kelvinchow23/photo-reactor/README.md

# Photoreactor Rev B

An update to the [AC-SDL4 photo-reactor](https://github.com/AC-SDL4/photo-reactor)
using custom PCBs for a four-reactor controller and interchangeable LED/fan boards.

The **photoreactor project is Rev B**. Both PCB parts remain **Rev A**:
SDL4-0001 photoreactor-controller and SDL4-0002 photoreactor-led.

- [PCB designs, BOMs, Gerbers and STEP models](electrical/README.md)
- [MicroPython test programs](firmware/README.md)
- [Wiring diagram](electrical/docs/wiring/photoreactor-wiring.pdf)
- [DigiKey import list](electrical/outputs/procurement/2026-10-15/DigiKey-bulk-import.txt)
- [Housing development](mechanical/housing/README.md)

Prototype bring-up is in progress; see [bench results](docs/bench-results.md).
Housing CAD will be added later.
