kelvinchow23/photo-reactor/mechanical/README.md

# Mechanical files

- [New housing development](housing/README.md)
- [PCB mechanical assemblies, STEP and previews](../electrical/outputs/mechanical/Rev-A/SDL4_REV_A_mechanical-models.zip)

The housing belongs to the Photoreactor Rev B project; the PCB model package
reflects physical Rev A boards. Housing CAD will be added when ready.
