kelvinchow23/photo-reactor/electrical/outputs/controller/SDL4-0001_photoreactor-controller_Rev-A_2026-10-08/reports/back-silkscreen.png

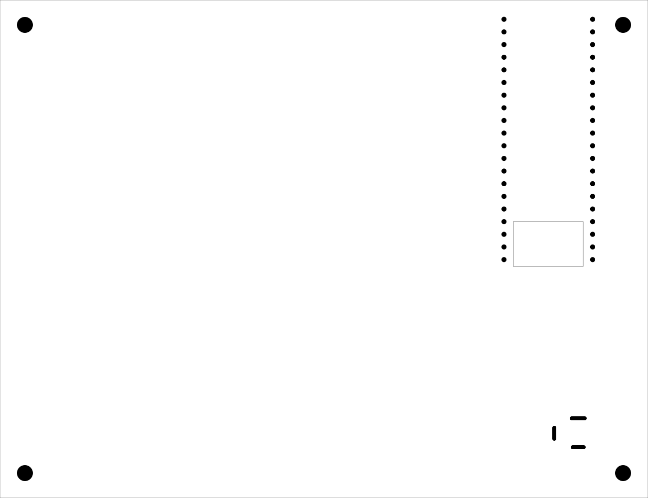
electrical/outputs/controller/SDL4-0001_photoreactor-controller_Rev-A_2026-10-08/reports/back-silkscreen.png
