kelvinchow23/photo-reactor/mechanical/housing/outputs/Rev-B/images/PR-RevB_Base_iso-back.png

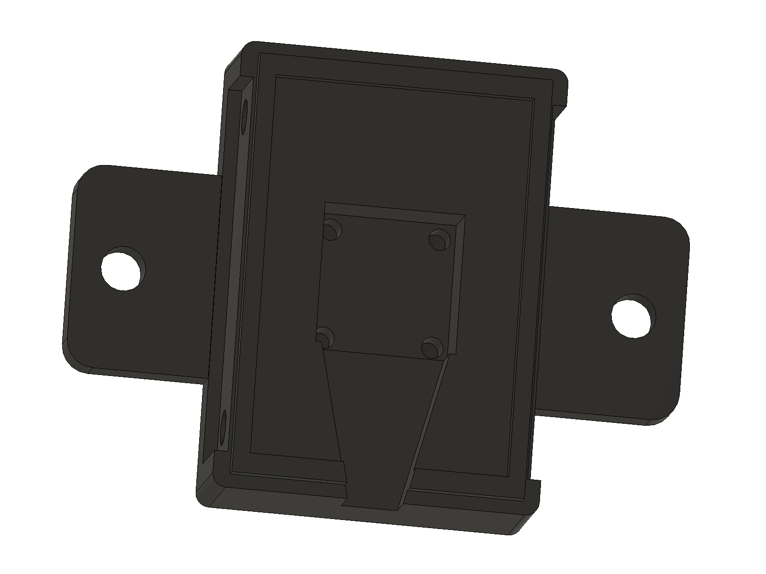
mechanical/housing/outputs/Rev-B/images/PR-RevB_Base_iso-back.png
