kelvinchow23/photo-reactor/mechanical/housing/outputs/Rev-B/images/PR-RevB_Insert_8mL_iso-back.png

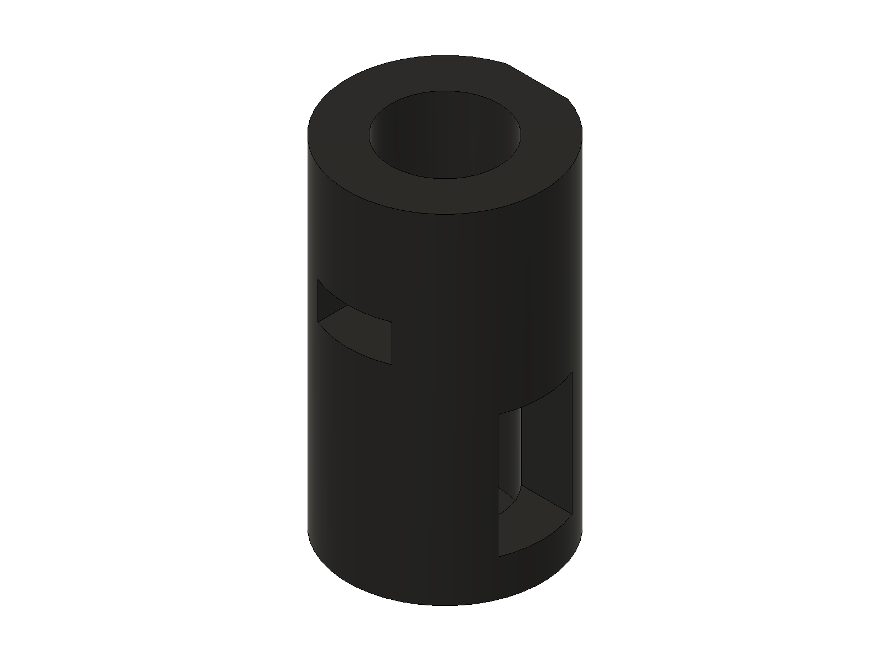
mechanical/housing/outputs/Rev-B/images/PR-RevB_Insert_8mL_iso-back.png
