kelvinchow23/photo-reactor/mechanical/housing/outputs/Rev-B/images/PR-RevB_Tower_iso-back.png

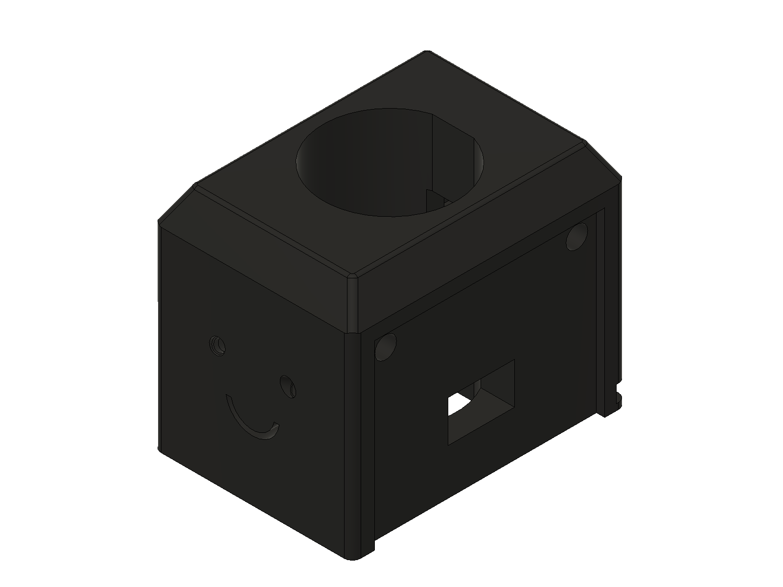
mechanical/housing/outputs/Rev-B/images/PR-RevB_Tower_iso-back.png
