kelvinchow23/photo-reactor/electrical/outputs/led_board/SDL4-0002_photoreactor-led_Rev-A_2026-10-08/SDL4-0002_photoreactor-led_Rev-A_2026-10-08_BOM.csv

Comment | Designator | Footprint | LCSC Part #
CL21A106KAYNNNE | C1 | C_0805_2012Metric | C15850
CC0805KRX7R9BB104 | C2 | C_0805_2012Metric | C49678
XL-HD6070UGC-A2-BD | D1 | LED_XINGLIGHT_XL_HD6070UGC_A2_BD | C42458855
JXT-IDC2.54-2X5P-A2 | J1 | IDC-Header_2x05_P2.54mm_Vertical_SMD | C54803513
S6B-PH-SM4-TB(LF)(SN) | J2 | JST_PH_S6B-PH-SM4-TB_1x06-1MP_P2.00mm_Horizontal | C265405
S4B-PH-SM4-TB(LF)(SN) | J3 | JST_PH_S4B-PH-SM4-TB_1x04-1MP_P2.00mm_Horizontal | C265102
0805W8F1002T5E | R1 | R_0805_2012Metric | C17414
