kelvinchow23/photo-reactor/electrical/outputs/controller/SDL4-0001_photoreactor-controller_Rev-A_2026-10-08/SDL4-0001_photoreactor-controller_Rev-A_2026-10-08_BOM.csv

Comment | Designator | Footprint | LCSC Part #
0805W8F1000T5E | R11,R15,R25,R29,R39,R43,R53,R57 | R_0805_2012Metric | C17408
0805W8F1001T5E | R14,R18,R28,R32,R42,R46,R56,R60 | R_0805_2012Metric | C17513
0805W8F1002T5E | R10,R13,R17,R21,R24,R27,R31,R35,R38,R41,R45,R49,R52,R55,R59,R7 | R_0805_2012Metric | C17414
0805W8F1003T5E | R1,R12,R16,R26,R3,R30,R40,R44,R54,R58 | R_0805_2012Metric | C149504
0805W8F3301T5E | R20,R23,R34,R37,R48,R51,R6,R9 | R_0805_2012Metric | C26010
0805W8F4701T5E | R2 | R_0805_2012Metric | C17673
1812L200/16DR | F1 | R_1812_4532Metric | C439873
2N7002 | Q_FAN1,Q_FAN2,Q_FAN3,Q_FAN4,Q_FAN5,Q_FAN6,Q_FAN7,Q_FAN8 | SOT-23 | C8545
AL8860WT-7 | U_LED1,U_LED2,U_LED3,U_LED4,U_LED5,U_LED6,U_LED7,U_LED8 | SOT-23-5 | C125330
B5819W SL | D_LED1,D_LED2,D_LED3,D_LED4,D_LED5,D_LED6,D_LED7,D_LED8 | D_SOD-123 | C8598
CC0805KRX7R9BB104 | C10,C13,C16,C2,C21,C24,C29,C3,C32,C37,C40,C9 | C_0805_2012Metric | C49678
CL21A106KAYNNNE | C4,C5,C8 | C_0805_2012Metric | C15850
CL21A475KAQNNNE | C12,C15,C20,C23,C28,C31,C36,C39 | C_0805_2012Metric | C1779
CL21B102KCANNNC | C17,C18,C25,C26,C33,C34,C41,C42 | C_0805_2012Metric | C15177
CL21B105KBFNNNE | C11,C14,C19,C22,C27,C30,C35,C38 | C_0805_2012Metric | C28323
CR1206FR430P05R | R19,R22,R33,R36,R47,R5,R50,R8 | R_1206_3216Metric | C175800
DMP3099L-7 | Q_REV | SOT-23 | C155244
TCC1210X7R226K250MT | C6,C7 | C_1210_3225Metric | C49118556
JXT-IDC2.54-2X5P-A2 | J_R1,J_R2,J_R3,J_R4 | JXT_IDC2.54_2X5P_A2 | C54803513
KT-0805G | D3 | LED_0805_2012Metric | C2297
MMSZ5240B | D_GZ | D_SOD-123 | C21564
PTS645SK43SMTR92LFS | SW_RST | SW_SPST_PTS645Sx43SMTR92 | C221871
RC0805FR-0718K2L | R4 | R_0805_2012Metric | C483023
SMAJ16A | D_TVS | D_SMA | C74561
SRN6045TA-680M | L2,L3,L4,L5,L6,L7,L8,L9 | L_Bourns_SRN6045TA | C1330786
SRN6045TA-6R8M | L1 | L_Bourns_SRN6045TA | C2041457
SS14 | D_VSYS | D_SMA | C2480
TPS563200DDCR | U_BUCK | SOT-23-6 | C97253
TSM-103-01-L-SV-TR | JP_FANV | Samtec_TSM-103_SV | C7074494
UWT1E101MCL1GS | C1 | CP_Elec_6.3x7.7_ControllerSilk | C87067
