kelvinchow23/photo-reactor/electrical/outputs/controller/SDL4-0001_photoreactor-controller_Rev-A_2026-10-08/step/SDL4-0001_photoreactor-controller_Rev-A_2026-10-08_mechanical-assembly.step

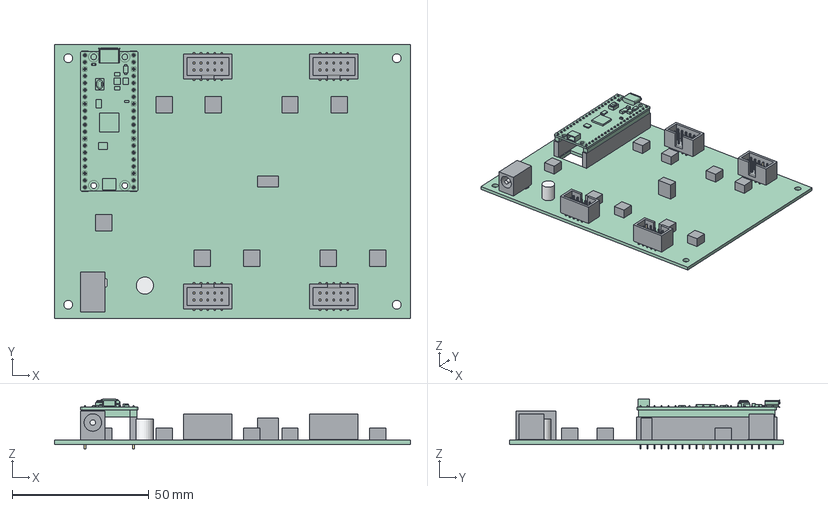
[picture p9: CAD file, 2026-11-10]
electrical/outputs/controller/SDL4-0001_photoreactor-controller_Rev-A_2026-10-08/step/SDL4-0001_photoreactor-controller_Rev-A_2026-10-08_mechanical-assembly.step
130.0 x 100.0 x 18.1 mm
PCB_nominal_finished_thickness
J_R1_housing
J_R1_contacts
J_R2_housing
J_R2_contacts
J_R3_housing
J_R3_contacts
J_R4_housing
J_R4_contacts
J_PWR_housing_envelope
J_PWR_centre_pin
J_PICO_socket_body_envelopes
J_PICO_socket_tails
J_PICO_Pico_H_KiCad_model
C1_7p7mm_height_envelope
JP_FANV_header_and_5V_shunt_envelope
L1_envelope
L2_envelope
L3_envelope
L4_envelope
L5_envelope
L6_envelope
L7_envelope
L8_envelope
L9_envelope
