kelvinchow23/photo-reactor/electrical/outputs/led_board/SDL4-0002_photoreactor-led_Rev-A_2026-10-08/step/SDL4-0002_photoreactor-led_Rev-A_2026-10-08_mechanical-assembly.step

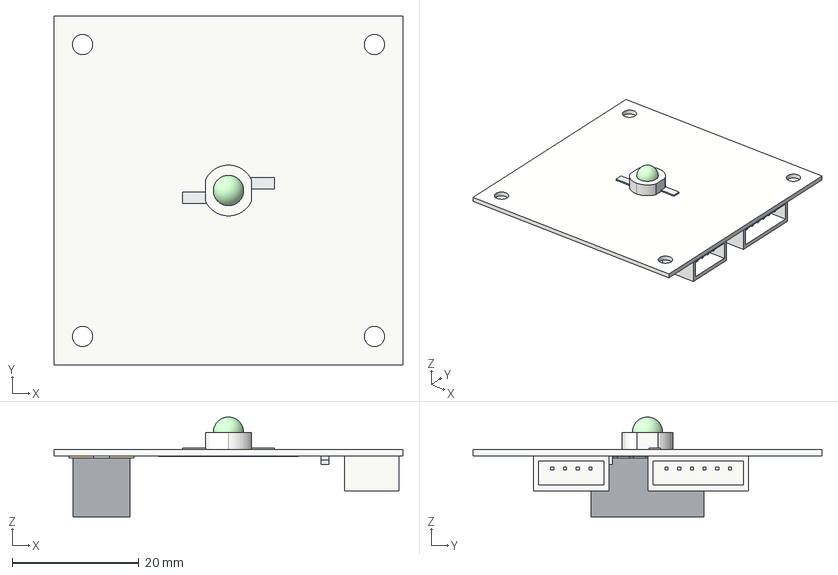
[picture p10: CAD file, 2026-11-10]
electrical/outputs/led_board/SDL4-0002_photoreactor-led_Rev-A_2026-10-08/step/SDL4-0002_photoreactor-led_Rev-A_2026-10-08_mechanical-assembly.step
55.0 x 55.0 x 15.8 mm
PCB_nominal_finished_thickness
D1_body_envelope
D1_optical_dome_approx
D1_terminals
J1_housing
J1_contacts
J2_housing_envelope
J2_contacts
J3_housing_envelope
J3_contacts
C1_envelope
C2_envelope
R1_envelope
REAR_22x22_HEATSINK_CONTACT_AREA
