kelvinchow23/photo-reactor/electrical/outputs/led_board/SDL4-0002_photoreactor-led_Rev-A_2026-10-08/step/SDL4-0002_photoreactor-led_Rev-A_2026-10-08_board-only.step

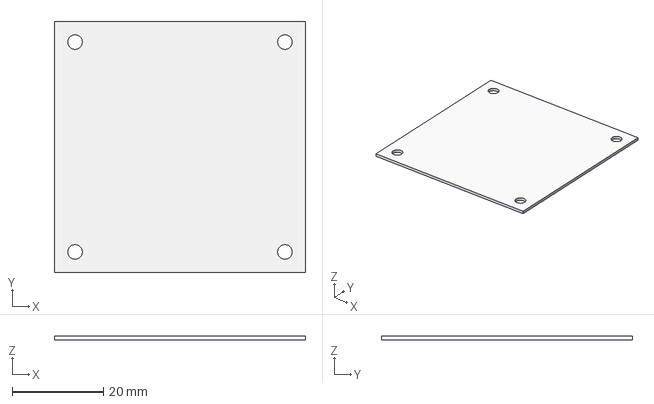
[picture p11: CAD file, 2026-11-10]
electrical/outputs/led_board/SDL4-0002_photoreactor-led_Rev-A_2026-10-08/step/SDL4-0002_photoreactor-led_Rev-A_2026-10-08_board-only.step
55.0 x 55.0 x 0.84 mm
