kelvinchow23/photo-reactor/mechanical/housing/outputs/Rev-B/step/PR-RevB_Insert_8mL.step

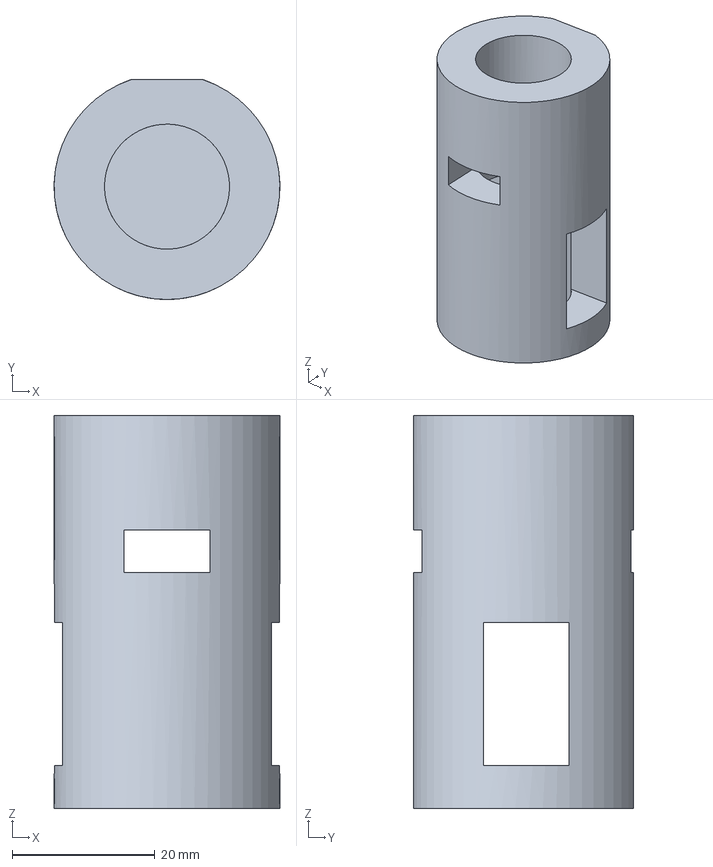
[picture p12: CAD file, 2026-11-10]
mechanical/housing/outputs/Rev-B/step/PR-RevB_Insert_8mL.step
31.6 x 30.8 x 55.0 mm
