kelvinchow23/photo-reactor/electrical/outputs/controller/SDL4-0001_photoreactor-controller_Rev-A_2026-10-08/step/SDL4-0001_photoreactor-controller_Rev-A_2026-10-08_board-only.step

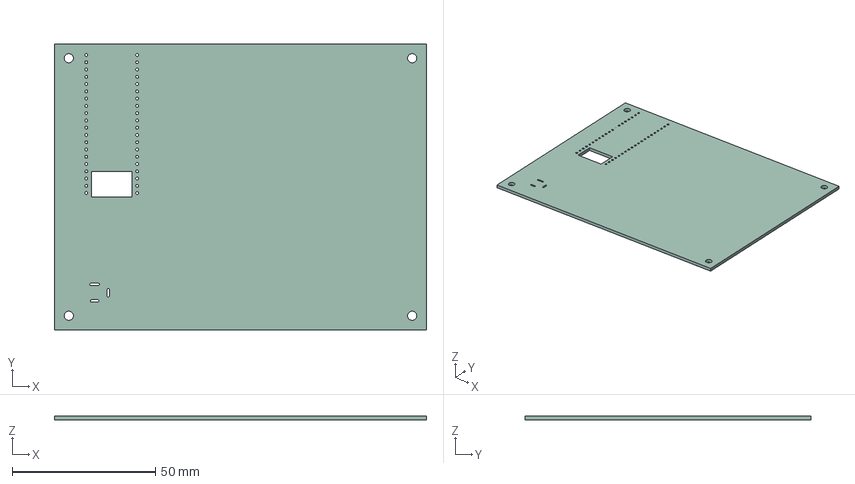
[picture p13: CAD file, 2026-11-10]
electrical/outputs/controller/SDL4-0001_photoreactor-controller_Rev-A_2026-10-08/step/SDL4-0001_photoreactor-controller_Rev-A_2026-10-08_board-only.step
130.0 x 100.0 x 1.51 mm
