kelvinchow23/photo-reactor/electrical/outputs/led_board/SDL4-0002_photoreactor-led_Rev-A_2026-10-08/step/SDL4-0002_photoreactor-led_Rev-A_2026-10-08_heatsink-clearance.step

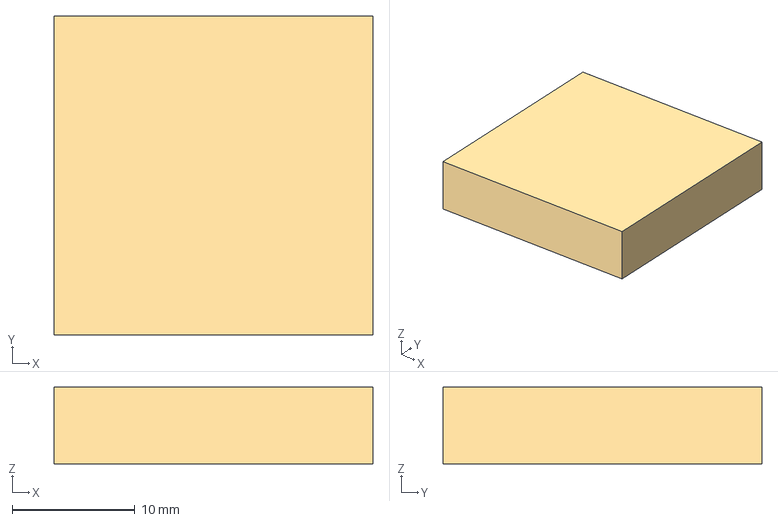
[picture p14: CAD file, 2026-11-10]
electrical/outputs/led_board/SDL4-0002_photoreactor-led_Rev-A_2026-10-08/step/SDL4-0002_photoreactor-led_Rev-A_2026-10-08_heatsink-clearance.step
26.0 x 26.0 x 6.25 mm
