kelvinchow23/photo-reactor/mechanical/housing/outputs/Rev-B/step/PR-RevB_Base.step

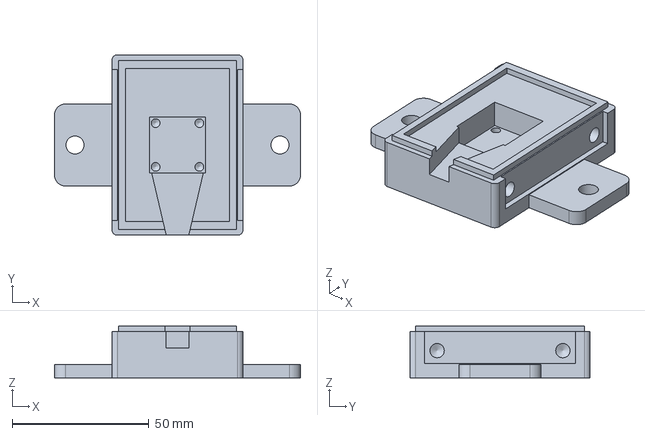
[picture p15: CAD file, 2026-11-10]
mechanical/housing/outputs/Rev-B/step/PR-RevB_Base.step
90.0 x 66.0 x 19.0 mm
