kelvinchow23/photo-reactor/mechanical/housing/outputs/Rev-B/step/PR-RevB_Tower.step

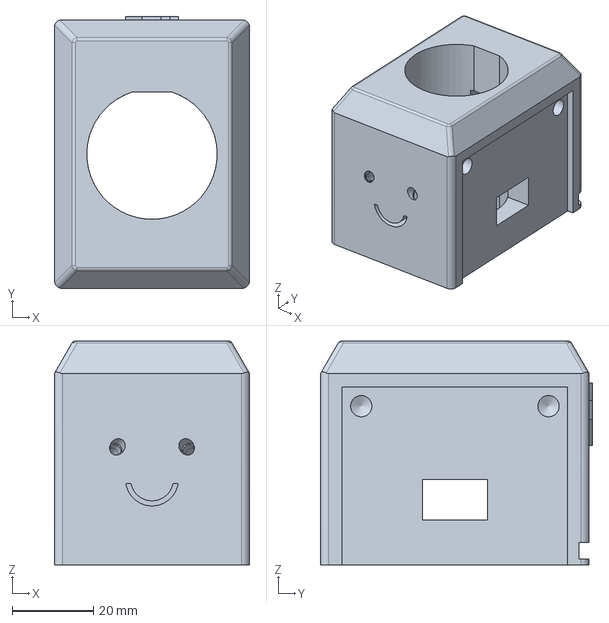
[picture p16: CAD file, 2026-11-10]
mechanical/housing/outputs/Rev-B/step/PR-RevB_Tower.step
48.0 x 66.8 x 55.0 mm
