kelvinchow23/photo-reactor/(list of files, cad)

Other CAD files:
mechanical/housing/outputs/Rev-B/stl/PR-RevB_Base.stl
mechanical/housing/outputs/Rev-B/stl/PR-RevB_Insert_8mL.stl
mechanical/housing/outputs/Rev-B/stl/PR-RevB_Tower.stl
