kelvinchow23/photo-reactor/electrical/docs/wiring/photoreactor-wiring.pdf

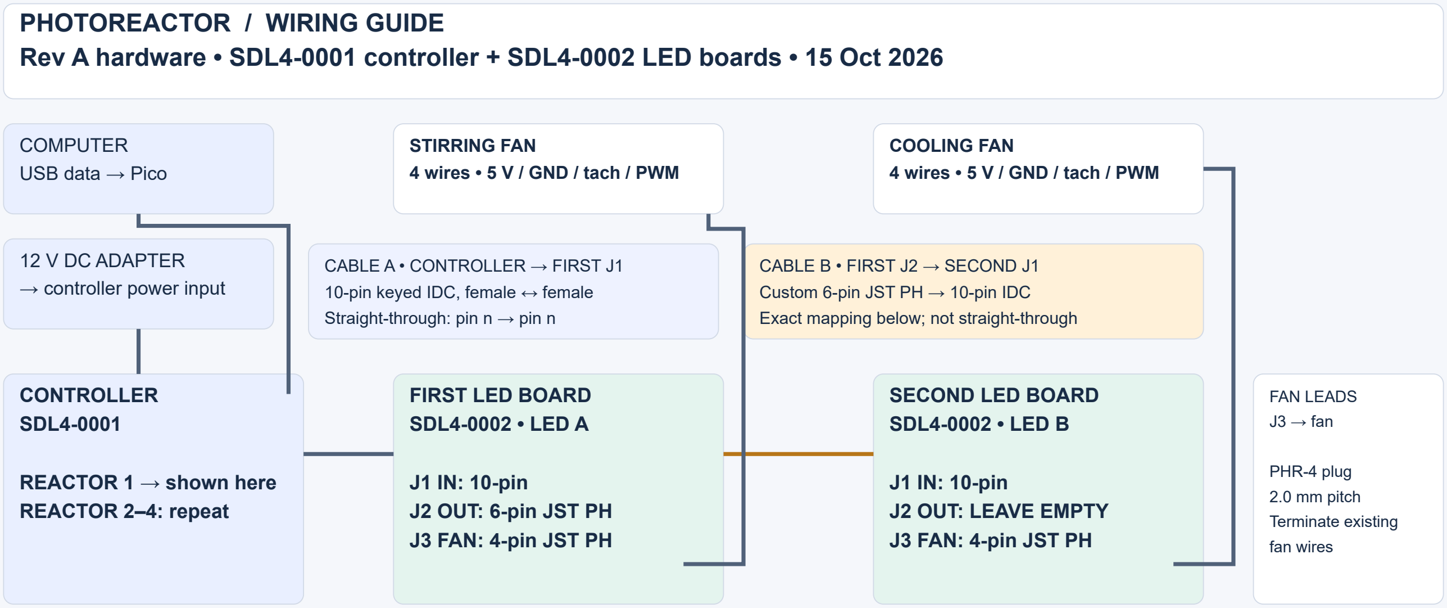
[picture p17: figure]
PHOTOREACTOR / WIRING GUIDE; COMPUTER USB data → Pico; 12 V DC ADAPTER → controller power input; CONTROLLER SDL4-0001; REACTOR 1 → shown here REACTOR 2–4: repeat; FIRST LED BOARD SDL4-0002 • LED A; J1 IN: 10-pin J2 OUT: 6-pin JST PH J3 FAN: 4-pin JST PH; SECOND LED BOARD SDL4-0002 • LED B; J1 IN: 10-pin J2 OUT: LEAVE EMPTY J3 FAN: 4-pin JST PH; CABLE A • CONTROLLER → FIRST J1 10-pin keyed IDC, female ↔ female Straight-through: pin n → pin n; CABLE B • FIRST J2 → SECOND J1 Custom 6-pin JST PH → 10-pin IDC Exact mapping below; not straight-through; STIRRING FAN 4 wires • 5 V / GND / tach / PWM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

## Rev A hardware • SDL4-0001 controller + SDL4-0002 LED boards • 15 Oct 2026

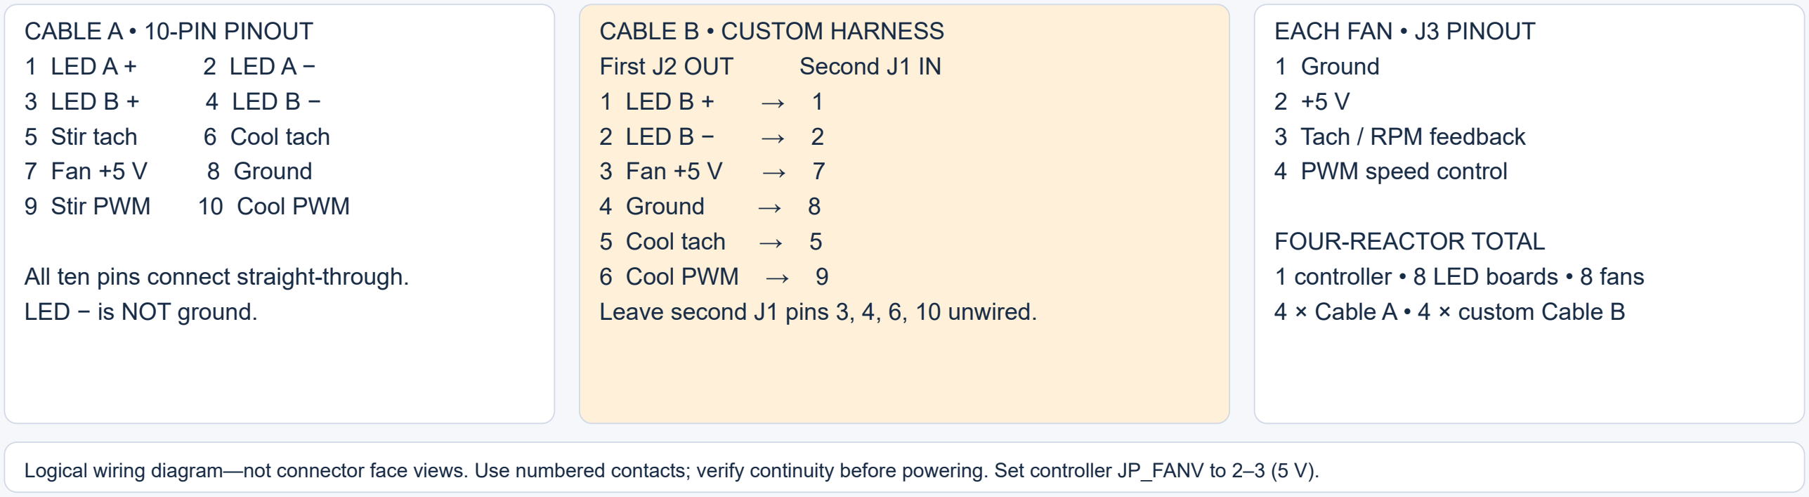
[picture p18: figure]
CABLE A • 10-PIN PINOUT; 1 LED A +; 2 LED A −; 3 LED B +; 4 LED B −; 5 Stir tach; 6 Cool tach; 7 Fan +5 V; 8 Ground; 9 Stir PWM; 10 Cool PWM; All ten pins connect straight-through. LED − is NOT ground.; CABLE B • CUSTOM HARNESS; First J2 OUT; Second J1 IN; 1 LED B +; 2 LED B −; 3 Fan +5 V; 4 Ground; 5 Cool tach; 6 Cool PWM → 9; EACH FAN • J3 PINOUT 1 Ground 2 +5 V 3 Tach / RPM feedback 4 PWM speed control; FOUR-REACTOR TOTAL 1 controller • 8 LED boards • 8 fans 4 × Cable A • 4 × custom Cable B

Leave second J1 pins 3, 4, 6, 10 unwired.

Logical wiring diagram—not connector face views. Use numbered contacts; verify continuity before powering. Set controller JP_FANV to 2–3 (5 V).
