kelvinchow23/photo-reactor/electrical/docs/wiring/photoreactor-wiring.png

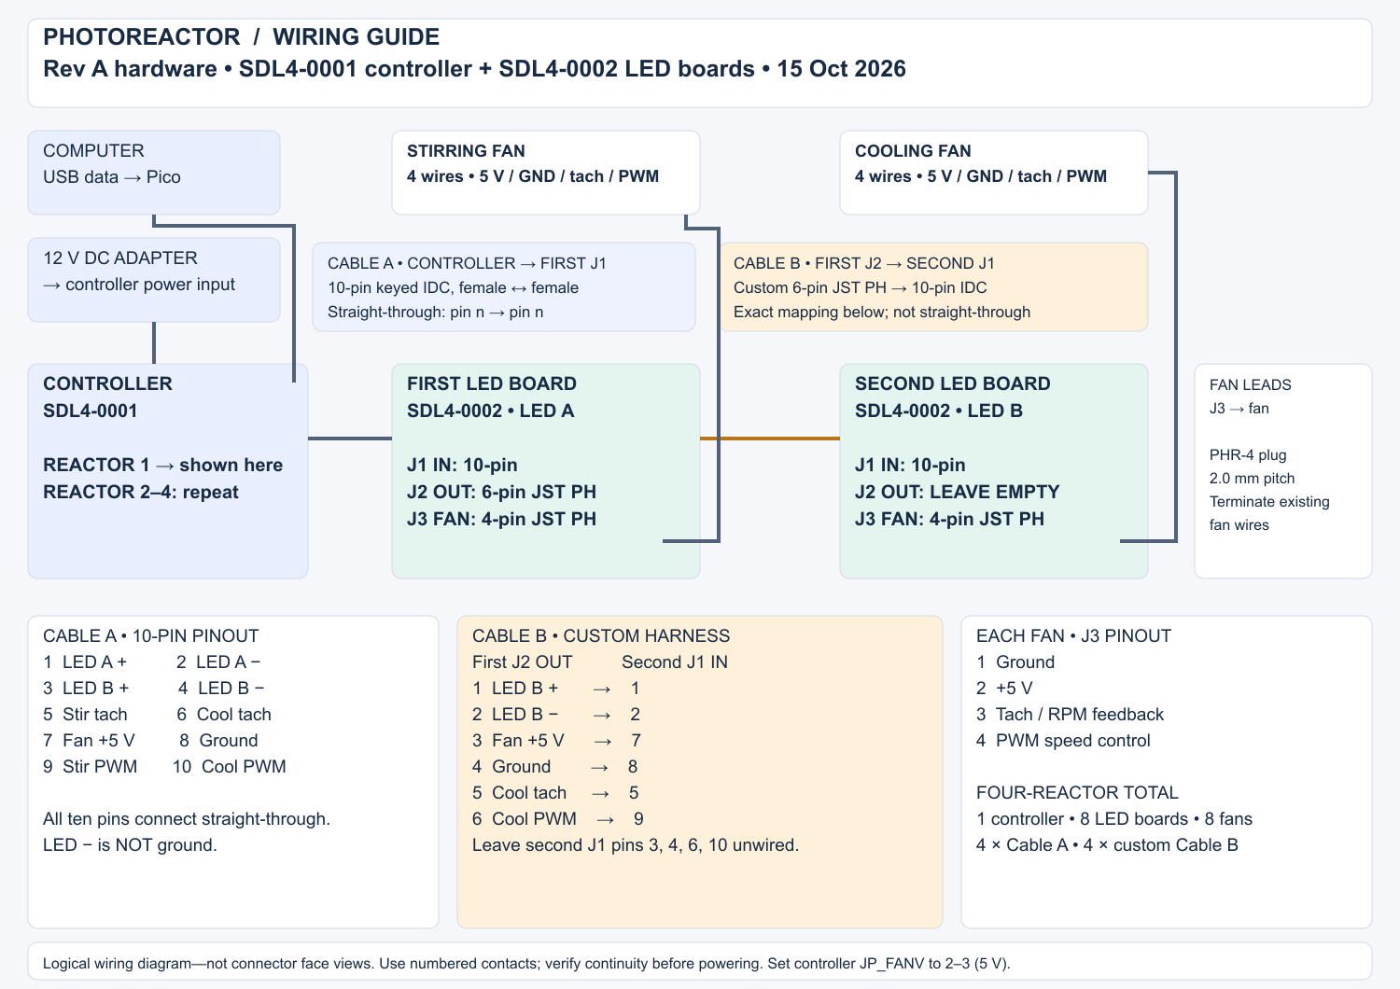
electrical/docs/wiring/photoreactor-wiring.png
