kelvinchow23/photo-reactor/electrical/outputs/led_board/SDL4-0002_photoreactor-led_Rev-A_2026-10-08/step/mechanical-assembly-top.png

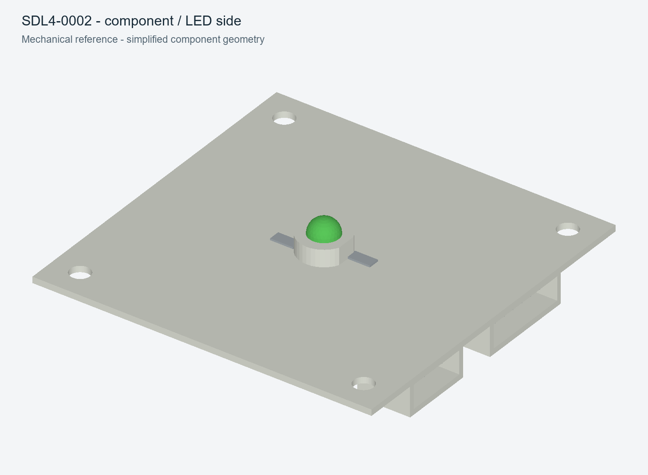
electrical/outputs/led_board/SDL4-0002_photoreactor-led_Rev-A_2026-10-08/step/mechanical-assembly-top.png
