kelvinchow23/photo-reactor/electrical/designs/led_board/photoreactor_led.kicad_pcb

## KiCad design electrical/designs/led_board/photoreactor_led.kicad_pcb (2026-11-10)

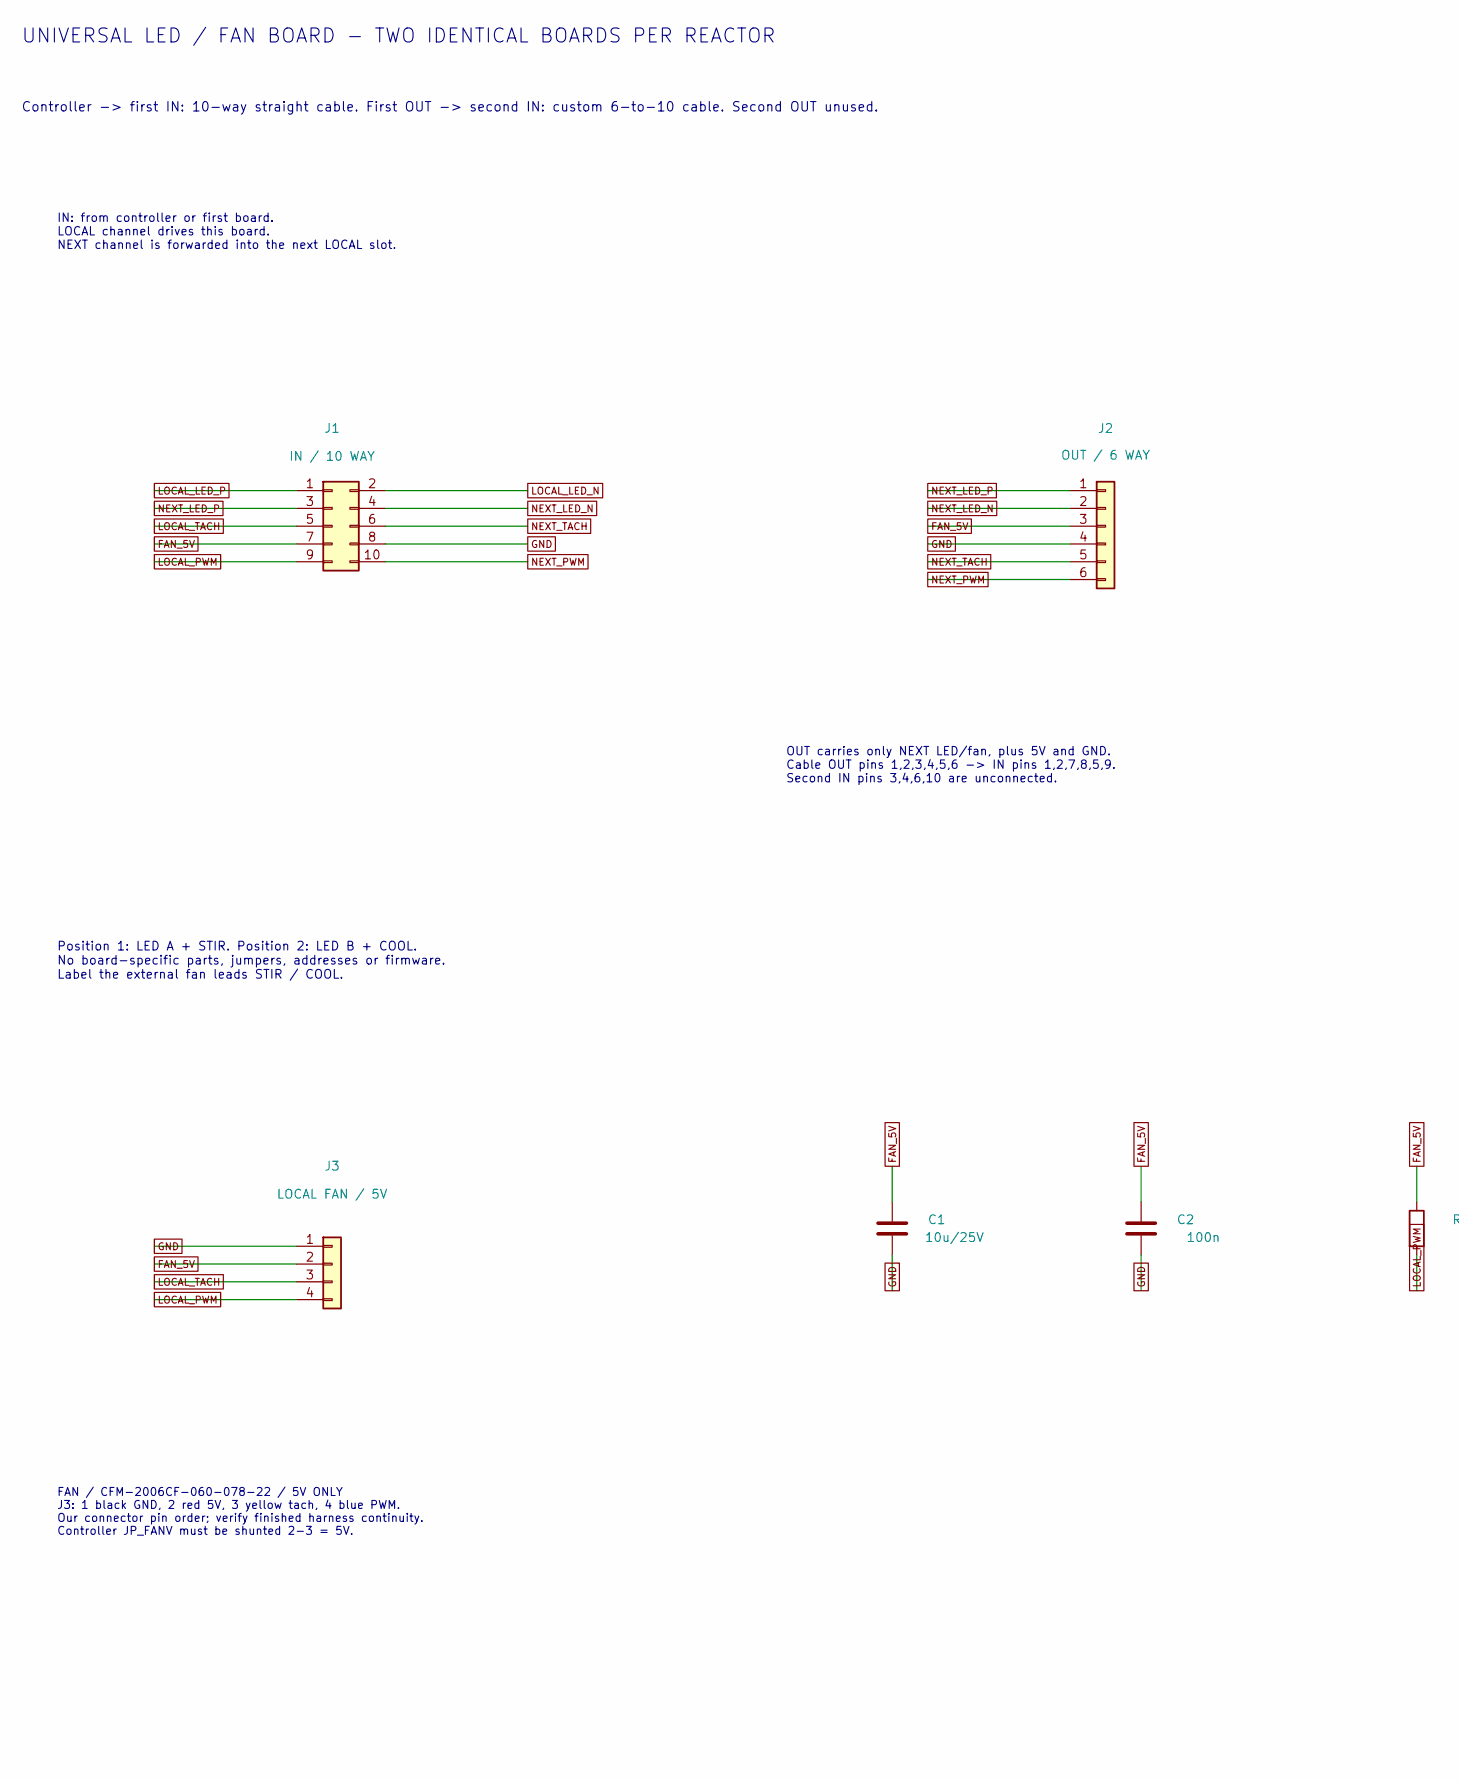
[picture p24: schematic photoreactor_led.kicad_sch, C.5 square LED and fan board, part in row 1, column 1]

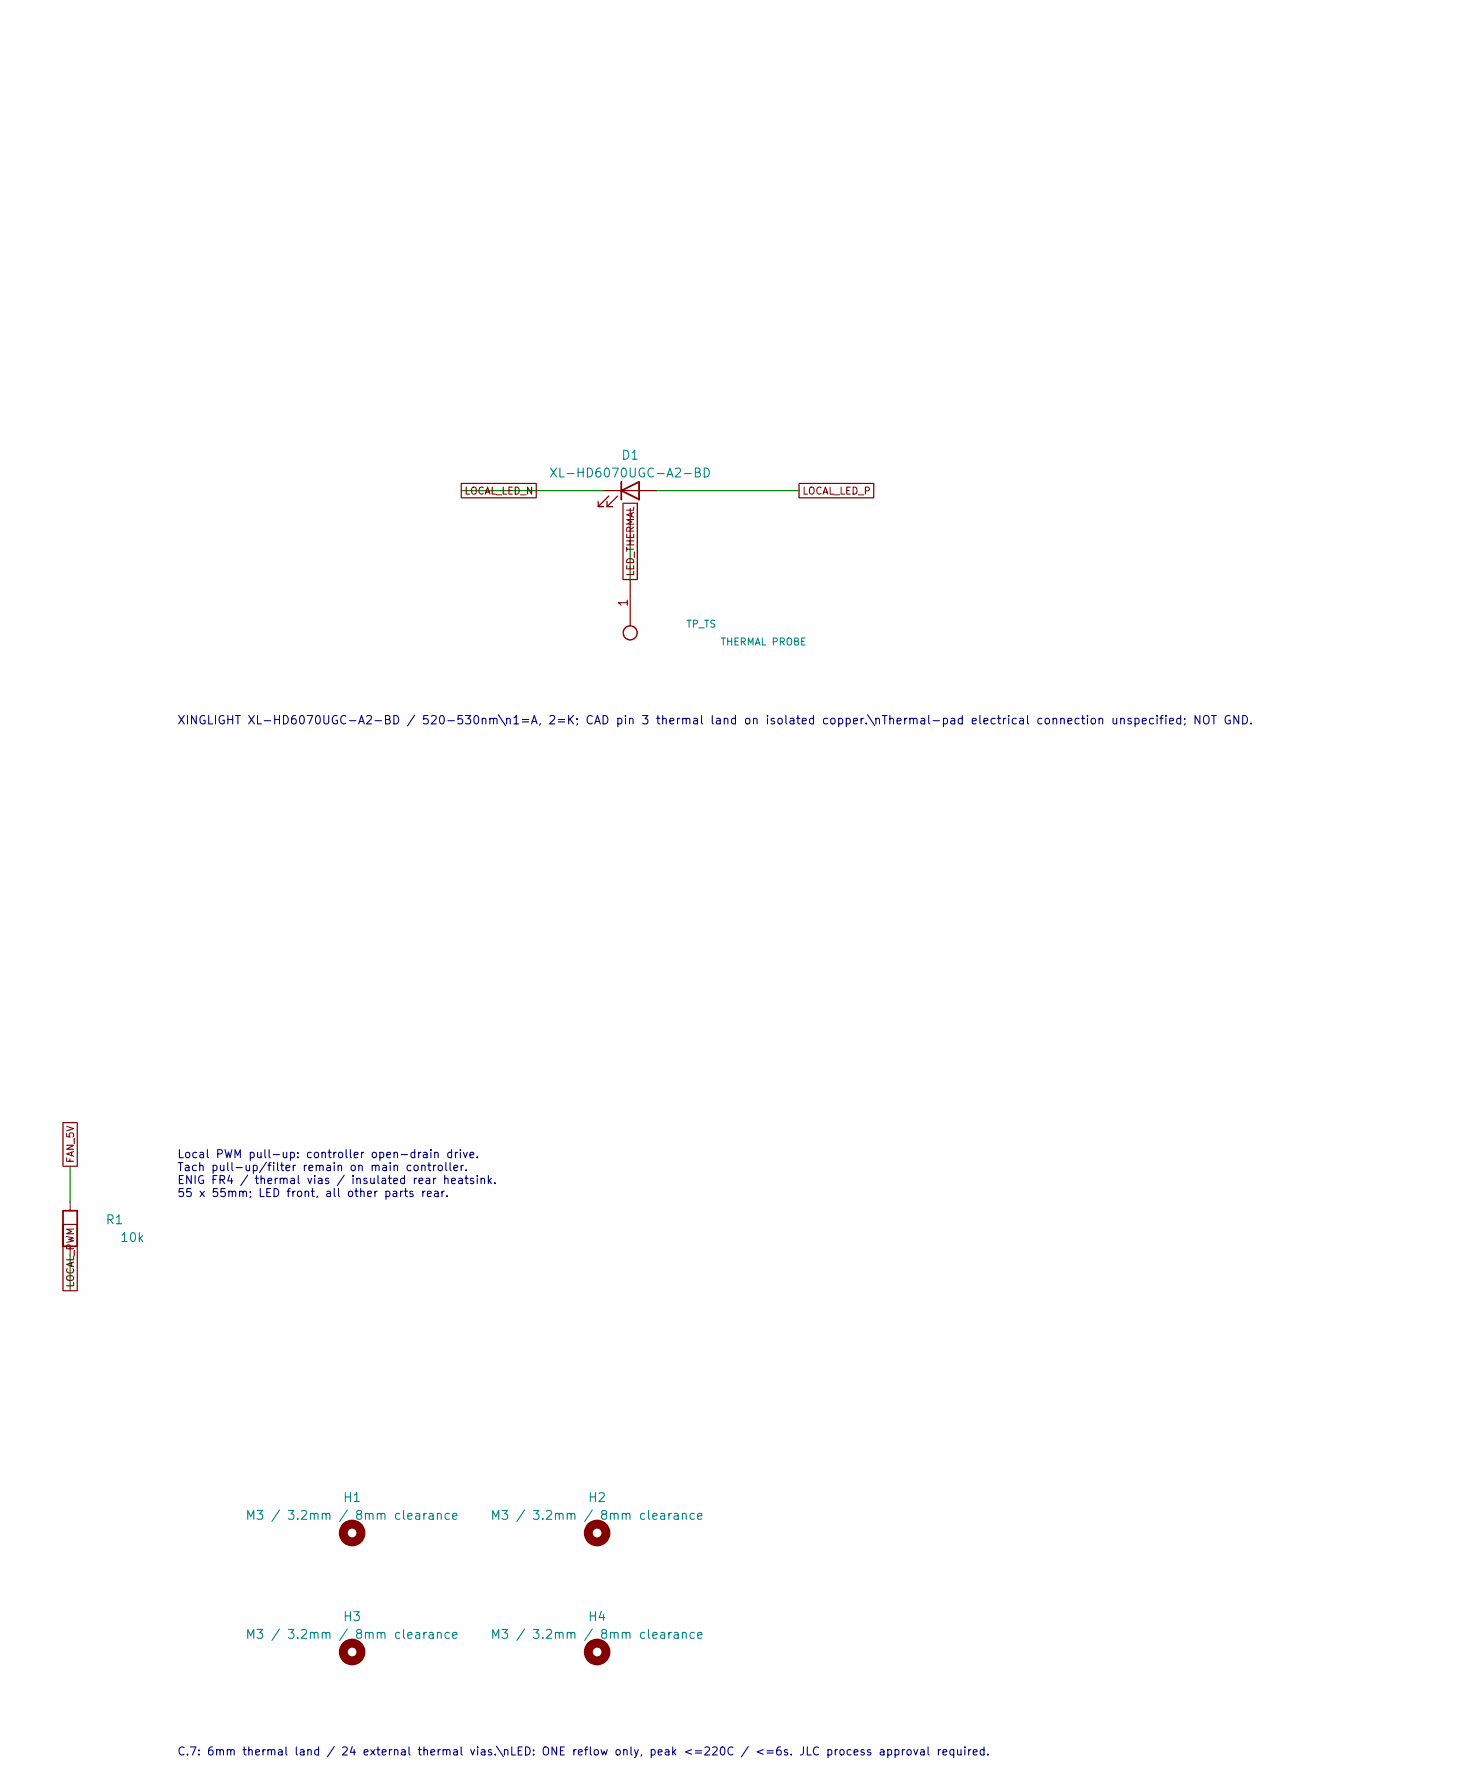
[picture p25: schematic photoreactor_led.kicad_sch, C.5 square LED and fan board, part in row 1, column 2]

Parts:
C1: 10u/25V; C_0805_2012Metric; MPN CL21A106KAYNNNE
C2: 100n; C_0805_2012Metric; MPN CC0805KRX7R9BB104
D1: XL-HD6070UGC-A2-BD; LED_XINGLIGHT_XL_HD6070UGC_A2_BD; MPN XL-HD6070UGC-A2-BD
H1, H2, H3, H4: M3 / 3.2mm / 8mm clearance; MountingHole_M3_3.2mm_8mm_Clearance
J1: IN / 10 WAY; IDC-Header_2x05_P2.54mm_Vertical_SMD; MPN JXT-IDC2.54-2X5P-A2
J2: OUT / 6 WAY; JST_PH_S6B-PH-SM4-TB_1x06-1MP_P2.00mm_Horizontal; MPN S6B-PH-SM4-TB(LF)(SN)
J3: LOCAL FAN / 5V; JST_PH_S4B-PH-SM4-TB_1x04-1MP_P2.00mm_Horizontal; MPN S4B-PH-SM4-TB(LF)(SN)
R1: 10k; R_0805_2012Metric; MPN 0805W8F1002T5E
TP_TS: THERMAL PROBE; Thermal_Probe_Window

Connections:
FAN_5V: C1.1, C2.1, J1.7, J2.3, J3.2, R1.1
GND: C1.2, C2.2, J1.8, J2.4, J3.1
LED_THERMAL: D1.3 (TH), TP_TS.1
LOCAL_LED_N: D1.2 (K), J1.2
LOCAL_LED_P: D1.1 (A), J1.1
LOCAL_PWM: J1.9, J3.4, R1.2
LOCAL_TACH: J1.5, J3.3
NEXT_LED_N: J1.4, J2.2
NEXT_LED_P: J1.3, J2.1
NEXT_PWM: J1.10, J2.6
NEXT_TACH: J1.6, J2.5

Notes on the sheet:
UNIVERSAL LED / FAN BOARD - TWO IDENTICAL BOARDS PER REACTOR
Controller -> first IN: 10-way straight cable. First OUT -> second IN: custom 6-to-10 cable. Second OUT unused.
IN: from controller or first board. LOCAL channel drives this board. NEXT channel is forwarded into the next LOCAL slot.
OUT carries only NEXT LED/fan, plus 5V and GND. Cable OUT pins 1,2,3,4,5,6 -> IN pins 1,2,7,8,5,9. Second IN pins 3,4,6,10 are unconnected.
XINGLIGHT XL-HD6070UGC-A2-BD / 520-530nm\n1=A, 2=K; CAD pin 3 thermal land on isolated copper.\nThermal-pad electrical connection unspecified; NOT GND.
Position 1: LED A + STIR. Position 2: LED B + COOL. No board-specific parts, jumpers, addresses or firmware. Label the external fan leads STIR / COOL.
FAN / CFM-2006CF-060-078-22 / 5V ONLY J3: 1 black GND, 2 red 5V, 3 yellow tach, 4 blue PWM. Our connector pin order; verify finished harness continuity. Controller JP_FANV must be shunted 2-3 = 5V.
Local PWM pull-up: controller open-drain drive. Tach pull-up/filter remain on main controller. ENIG FR4 / thermal vias / insulated rear heatsink. 55 x 55mm; LED front, all other parts rear.
C.7: 6mm thermal land / 24 external thermal vias.\nLED: ONE reflow only, peak <=220C / <=6s. JLC process approval required.

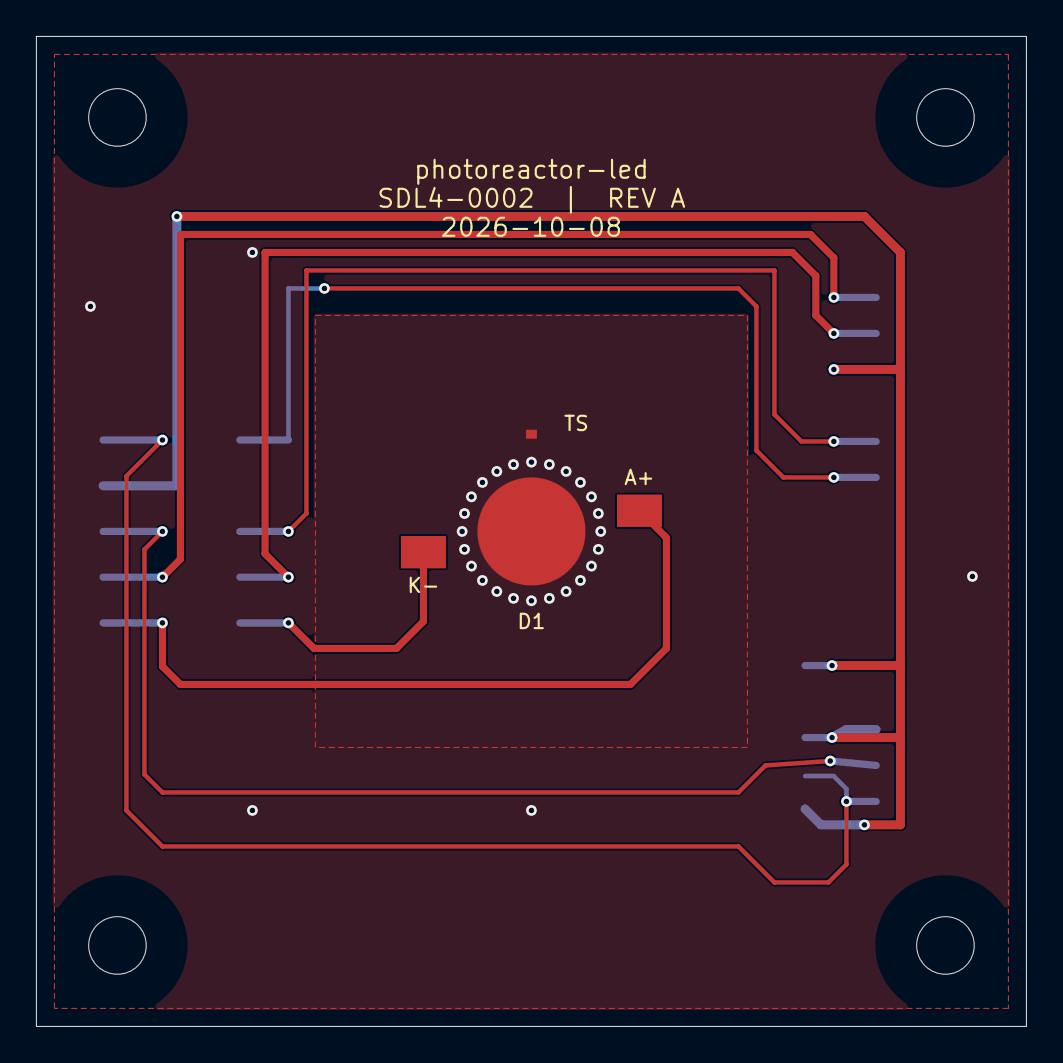
[picture p26: board photoreactor_led.kicad_pcb from above]

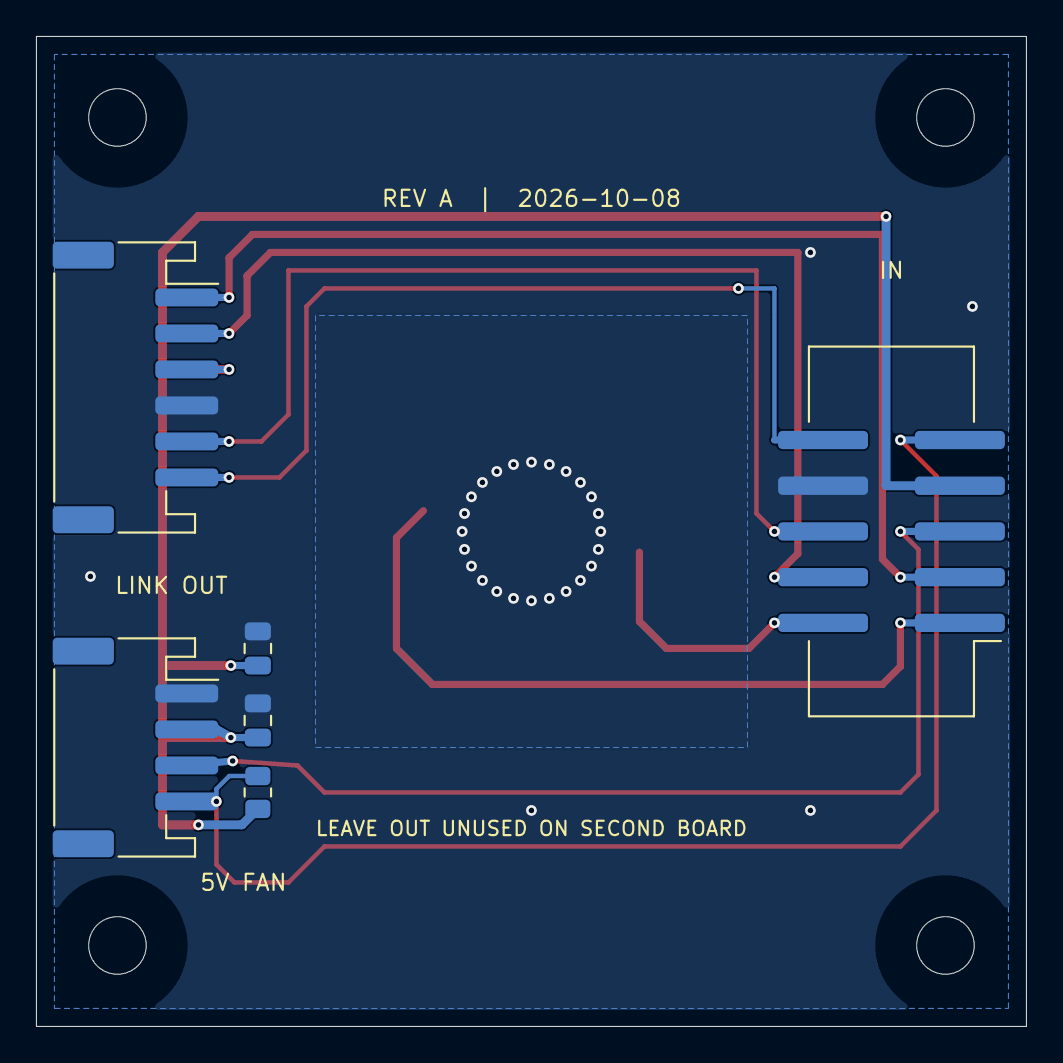
[picture p27: board photoreactor_led.kicad_pcb from below]

Board: 2 copper layers, 55.0 x 55.0 mm, 12 parts (6 on the bottom side), 11 nets.
