kelvinchow23/photo-reactor/electrical/designs/controller/photoreactor_quad.kicad_pcb

## KiCad design electrical/designs/controller/photoreactor_quad.kicad_pcb (2026-11-10)

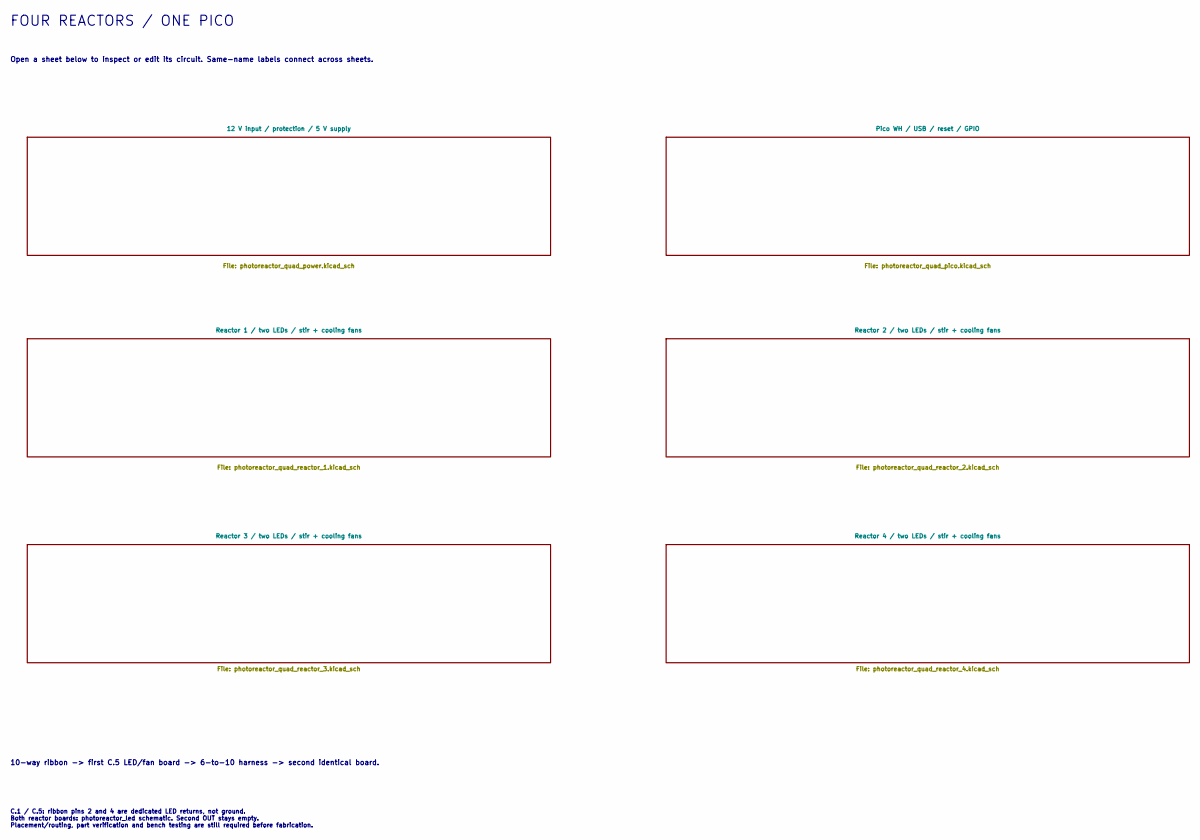
[picture p28: schematic photoreactor_quad.kicad_sch, LEDbyXample — four-reactor controller]

Notes on the sheet:
FOUR REACTORS / ONE PICO
Open a sheet below to inspect or edit its circuit. Same-name labels connect across sheets.
10-way ribbon -> first C.5 LED/fan board -> 6-to-10 harness -> second identical board.
C.1 / C.5: ribbon pins 2 and 4 are dedicated LED returns, not ground. Both reactor boards: photoreactor_led schematic. Second OUT stays empty. Placement/routing, part verification and bench testing are still required before fabrication.

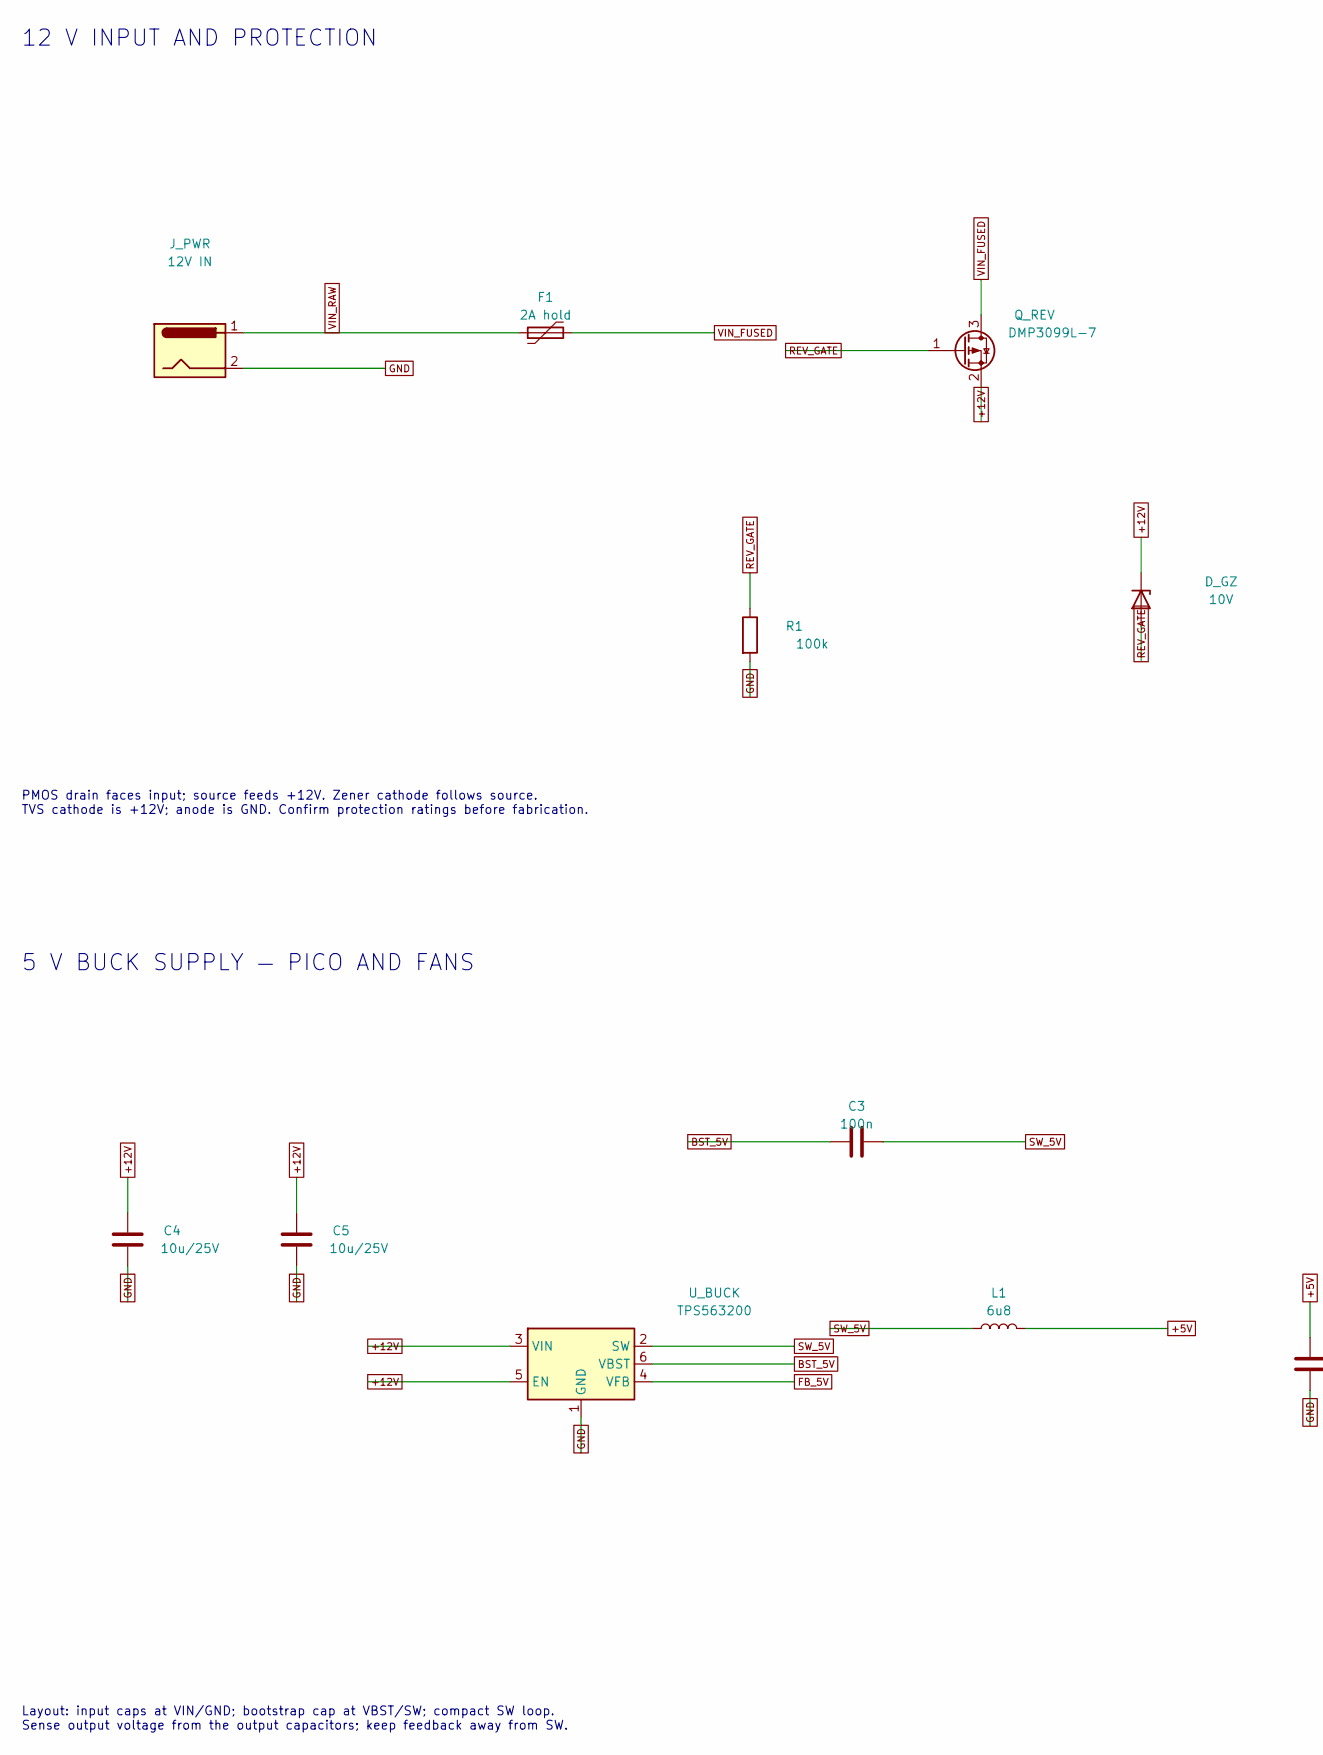
[picture p29: schematic photoreactor_quad_power.kicad_sch, Power input, protection and 5 V supply, part in row 1, column 1]

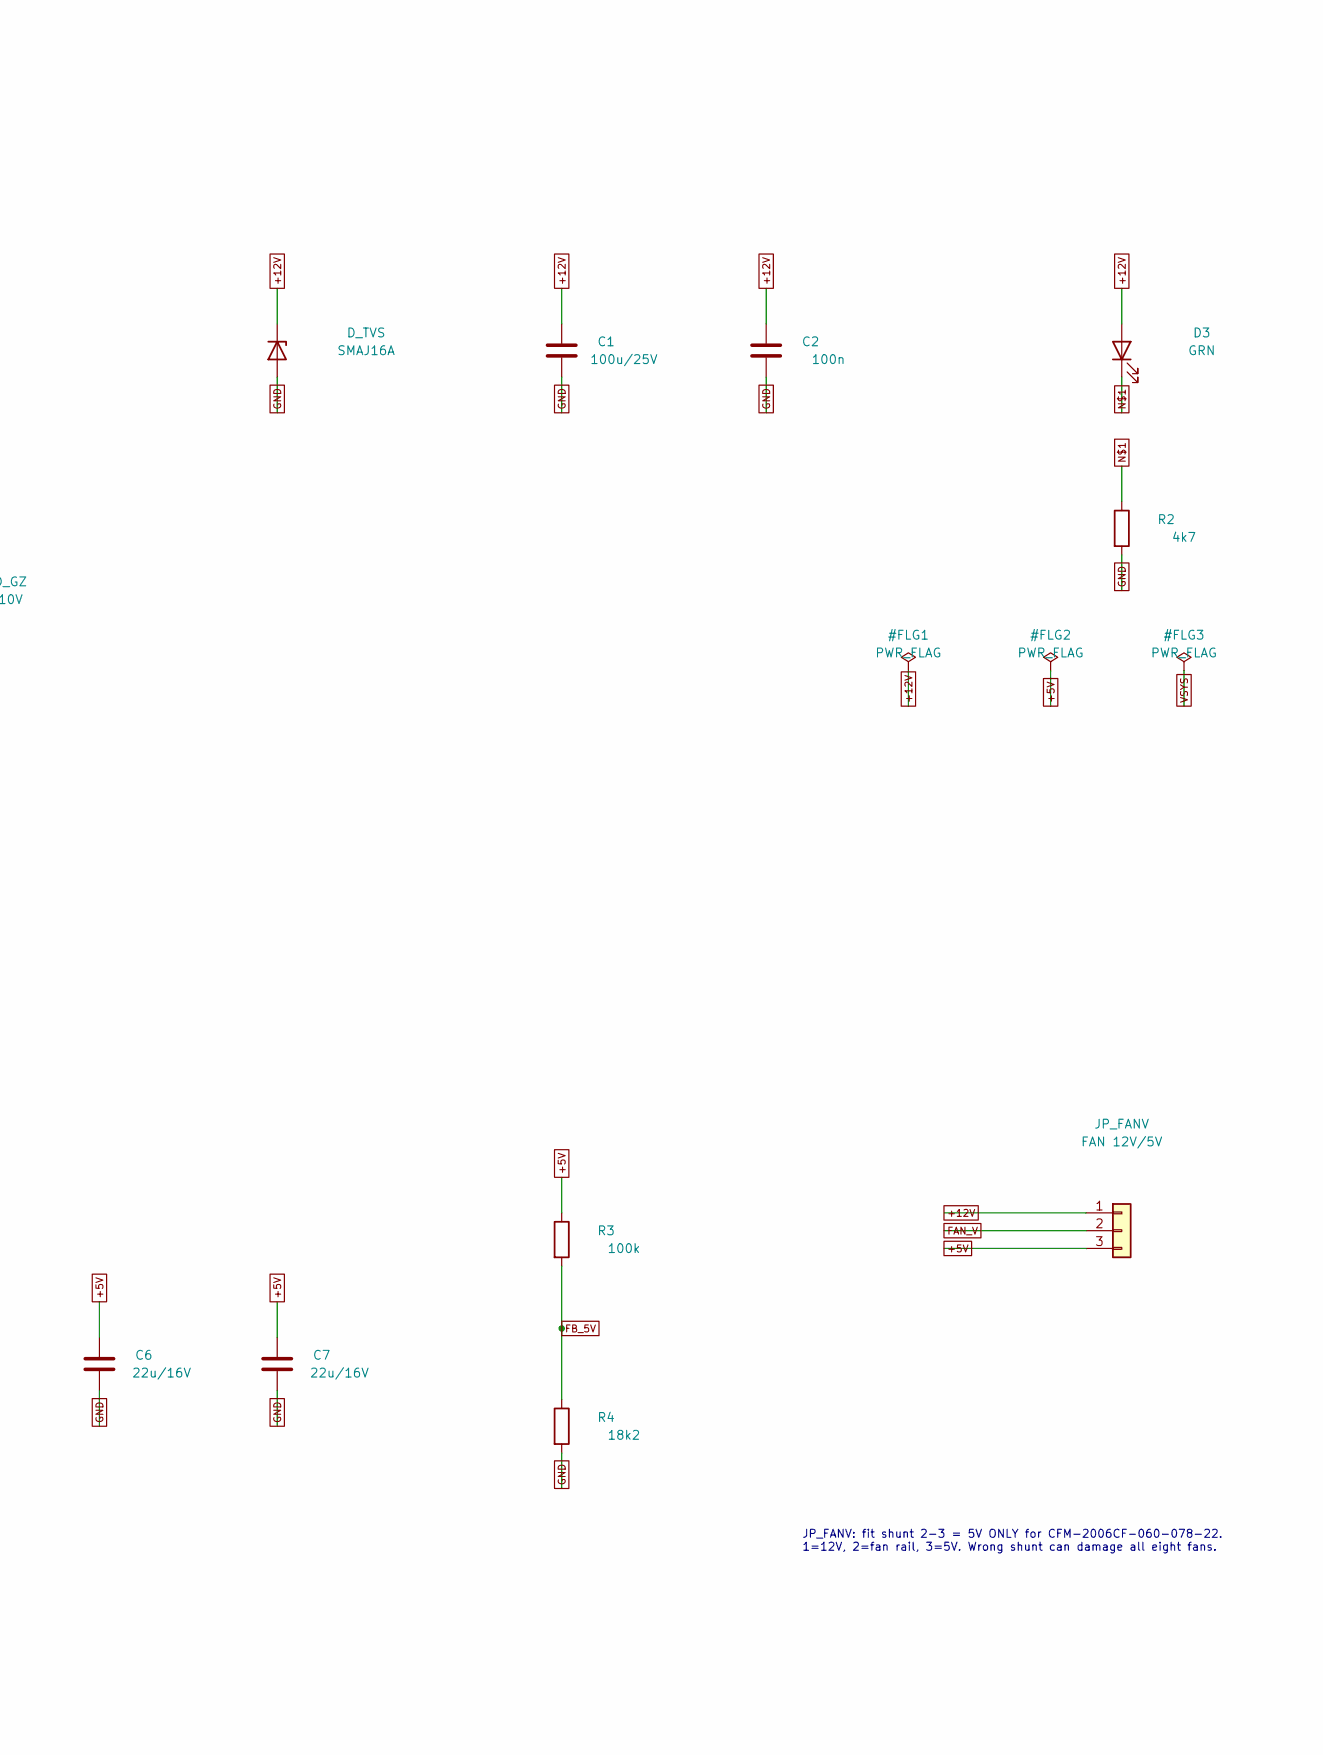
[picture p30: schematic photoreactor_quad_power.kicad_sch, Power input, protection and 5 V supply, part in row 1, column 2]

Parts:
C1: 100u/25V; CP_Elec_6.3x7.7_ControllerSilk; MPN UWT1E101MCL1GS
C2, C3: 100n; C_0805_2012Metric; MPN CC0805KRX7R9BB104; LCSC C49678
C4, C5: 10u/25V; C_0805_2012Metric; MPN CL21A106KAYNNNE; LCSC C15850
C6, C7: 22u/16V; C_1210_3225Metric; MPN TCC1210X7R226K250MT; LCSC C49118556
D3: GRN; LED_0805_2012Metric; MPN KT-0805G; LCSC C2297
D_GZ: 10V; D_SOD-123; MPN MMSZ5240B
D_TVS: SMAJ16A; D_SMA; MPN SMAJ16A
F1: 2A hold; R_1812_4532Metric; MPN 1812L200/16DR; LCSC C439873
JP_FANV: FAN 12V/5V; Samtec_TSM-103_SV; MPN TSM-103-01-L-SV-TR; LCSC C7074494
J_PWR: 12V IN; BarrelJack_Wuerth_6941xx301002; MPN 694106301002
L1: 6u8; L_Bourns_SRN6045TA; MPN SRN6045TA-6R8M
Q_REV: DMP3099L-7; SOT-23; MPN DMP3099L-7
R1, R3: 100k; R_0805_2012Metric; MPN 0805W8F1003T5E; LCSC C149504
R2: 4k7; R_0805_2012Metric; MPN 0805W8F4701T5E; LCSC C17673
R4: 18k2; R_0805_2012Metric; MPN RC0805FR-0718K2L; LCSC C483023
U_BUCK: TPS563200; SOT-23-6; MPN TPS563200DDCR

Connections:
+5V: C6.1, C7.1, JP_FANV.3, L1.2, R3.1; also elsewhere on the board
+12V: C1.1, C2.1, C4.1, C5.1, D3.2 (A), D_GZ.1 (K), D_TVS.1 (K), JP_FANV.1, Q_REV.2 (S), U_BUCK.3 (VIN), U_BUCK.5 (EN); also elsewhere on the board
BST_5V: C3.1, U_BUCK.6 (VBST)
FAN_V: JP_FANV.2; also elsewhere on the board
FB_5V: R3.2, R4.1, U_BUCK.4 (VFB)
GND: C1.2, C2.2, C4.2, C5.2, C6.2, C7.2, D_TVS.2 (A), J_PWR.2, R1.2, R2.2, R4.2, U_BUCK.1 (GND); also elsewhere on the board
unnamed: D3.1 (K), R2.1
REV_GATE: D_GZ.2 (A), Q_REV.1 (G), R1.1
SW_5V: C3.2, L1.1, U_BUCK.2 (SW)
VIN_FUSED: F1.2, Q_REV.3 (D)
VIN_RAW: F1.1, J_PWR.1

Notes on the sheet:
12 V INPUT AND PROTECTION
PMOS drain faces input; source feeds +12V. Zener cathode follows source. TVS cathode is +12V; anode is GND. Confirm protection ratings before fabrication.
5 V BUCK SUPPLY — PICO AND FANS
JP_FANV: fit shunt 2-3 = 5V ONLY for CFM-2006CF-060-078-22. 1=12V, 2=fan rail, 3=5V. Wrong shunt can damage all eight fans.
Layout: input caps at VIN/GND; bootstrap cap at VBST/SW; compact SW loop. Sense output voltage from the output capacitors; keep feedback away from SW.

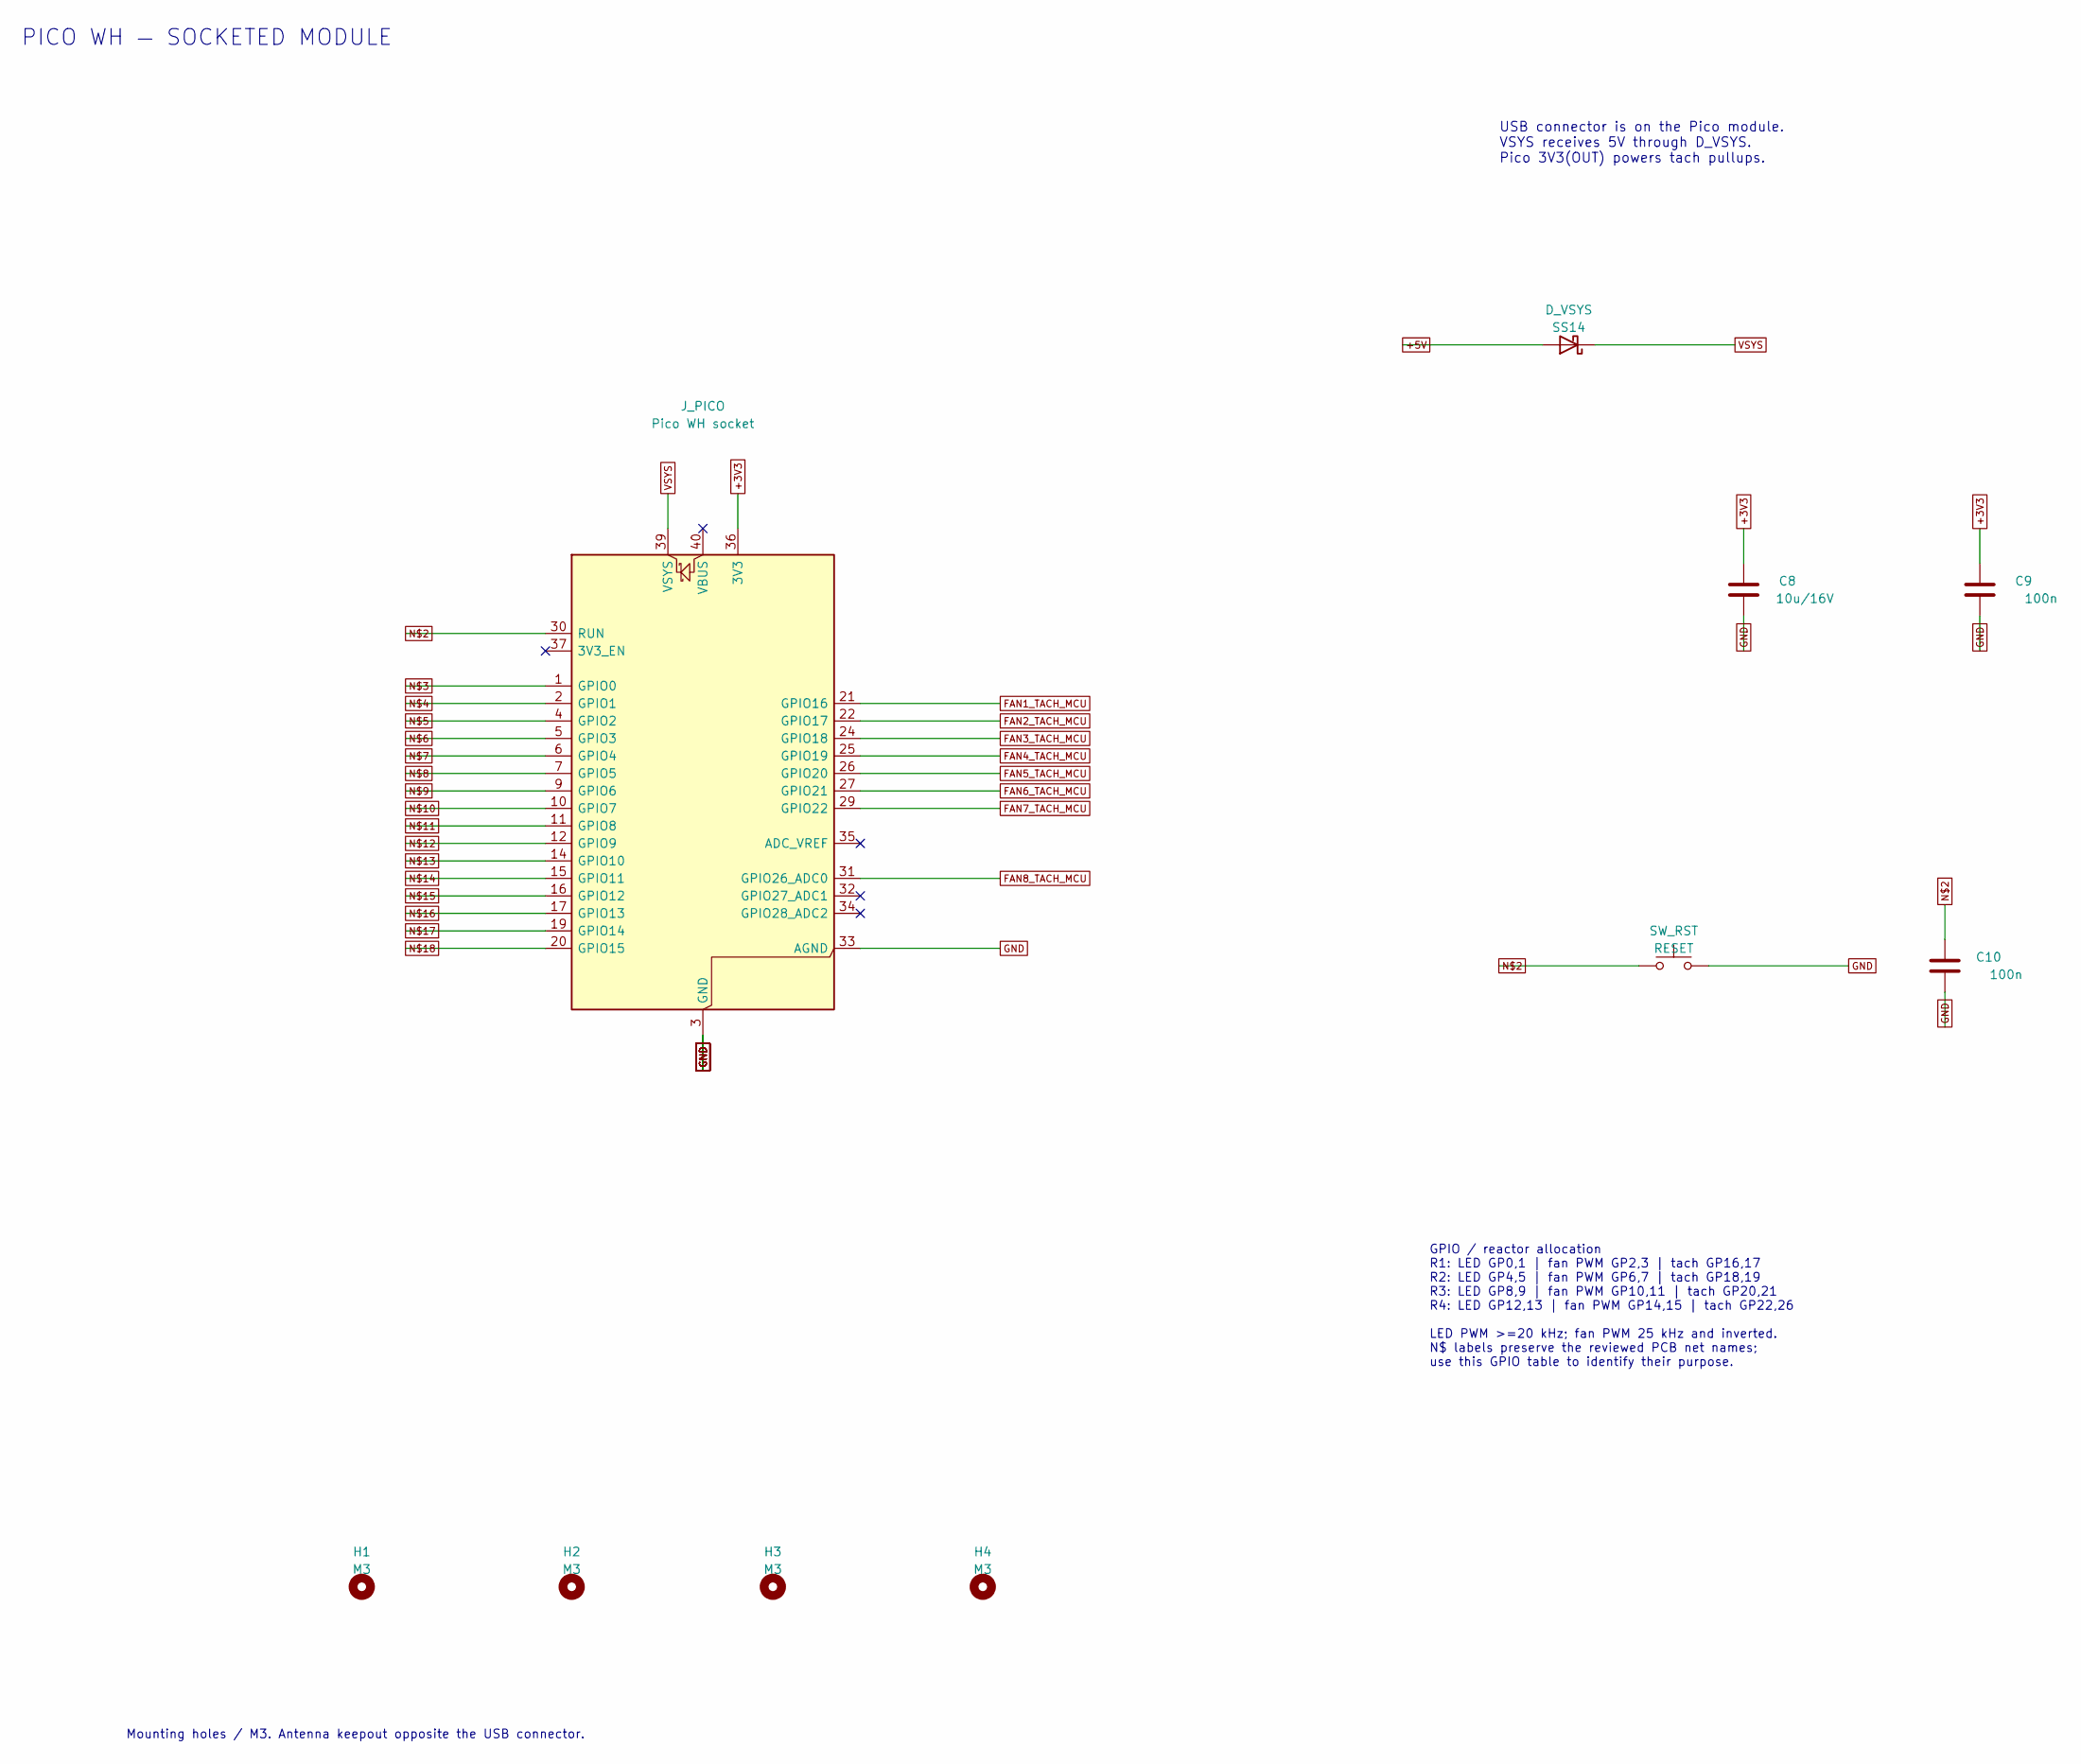
[picture p31: schematic photoreactor_quad_pico.kicad_sch, Pico WH, reset and GPIO allocation]

Parts:
C8: 10u/16V; C_0805_2012Metric; MPN CL21A106KAYNNNE; LCSC C15850
C9, C10: 100n; C_0805_2012Metric; MPN CC0805KRX7R9BB104; LCSC C49678
D_VSYS: SS14; D_SMA; MPN SS14
H1, H2, H3, H4: M3; MountingHole_3.2mm_M3_Pad
J_PICO: Pico WH socket; RPi_Pico_Socket_2x20_P2.54mm_Row17.78mm
SW_RST: RESET; SW_SPST_PTS645Sx43SMTR92; MPN PTS645SK43SMTR92LFS; LCSC C221871

Connections:
+3V3: C8.1, C9.1, J_PICO.36 (3V3); also elsewhere on the board
+5V: D_VSYS.2 (A); also elsewhere on the board
FAN1_TACH_MCU: J_PICO.21 (GPIO16); also elsewhere on the board
FAN2_TACH_MCU: J_PICO.22 (GPIO17); also elsewhere on the board
FAN3_TACH_MCU: J_PICO.24 (GPIO18); also elsewhere on the board
FAN4_TACH_MCU: J_PICO.25 (GPIO19); also elsewhere on the board
FAN5_TACH_MCU: J_PICO.26 (GPIO20); also elsewhere on the board
FAN6_TACH_MCU: J_PICO.27 (GPIO21); also elsewhere on the board
FAN7_TACH_MCU: J_PICO.29 (GPIO22); also elsewhere on the board
FAN8_TACH_MCU: J_PICO.31 (GPIO26_ADC0); also elsewhere on the board
GND: C8.2, C9.2, C10.2, J_PICO.3 (GND), J_PICO.8 (GND), J_PICO.13 (GND), J_PICO.18 (GND), J_PICO.23 (GND), J_PICO.28 (GND), J_PICO.33 (AGND), J_PICO.38 (GND), SW_RST.2; also elsewhere on the board
unnamed: C10.1, J_PICO.30 (RUN), SW_RST.1
unnamed 73: J_PICO.1 (GPIO0); also elsewhere on the board
unnamed 74: J_PICO.2 (GPIO1); also elsewhere on the board
unnamed 75: J_PICO.4 (GPIO2); also elsewhere on the board
unnamed 76: J_PICO.5 (GPIO3); also elsewhere on the board
unnamed 77: J_PICO.6 (GPIO4); also elsewhere on the board
unnamed 78: J_PICO.7 (GPIO5); also elsewhere on the board
unnamed 79: J_PICO.9 (GPIO6); also elsewhere on the board
unnamed 80: J_PICO.10 (GPIO7); also elsewhere on the board
unnamed 81: J_PICO.11 (GPIO8); also elsewhere on the board
unnamed 82: J_PICO.12 (GPIO9); also elsewhere on the board
unnamed 83: J_PICO.14 (GPIO10); also elsewhere on the board
unnamed 84: J_PICO.15 (GPIO11); also elsewhere on the board
unnamed 85: J_PICO.16 (GPIO12); also elsewhere on the board
unnamed 86: J_PICO.17 (GPIO13); also elsewhere on the board
unnamed 87: J_PICO.19 (GPIO14); also elsewhere on the board
unnamed 88: J_PICO.20 (GPIO15); also elsewhere on the board
VSYS: D_VSYS.1 (K), J_PICO.39 (VSYS)

Notes on the sheet:
PICO WH — SOCKETED MODULE
USB connector is on the Pico module. VSYS receives 5V through D_VSYS. Pico 3V3(OUT) powers tach pullups.
GPIO / reactor allocation R1: LED GP0,1 | fan PWM GP2,3 | tach GP16,17 R2: LED GP4,5 | fan PWM GP6,7 | tach GP18,19 R3: LED GP8,9 | fan PWM GP10,11 | tach GP20,21 R4: LED GP12,13 | fan PWM GP14,15 | tach GP22,26 LED PWM >=20 kHz; fan PWM 25 kHz and inverted. N$ labels preserve the reviewed PCB net 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
Mounting holes / M3. Antenna keepout opposite the USB connector.
