kelvinchow23/photo-reactor/electrical/designs/controller/photoreactor_quad.kicad_pcb

## KiCad design electrical/designs/controller/photoreactor_quad.kicad_pcb (continued)

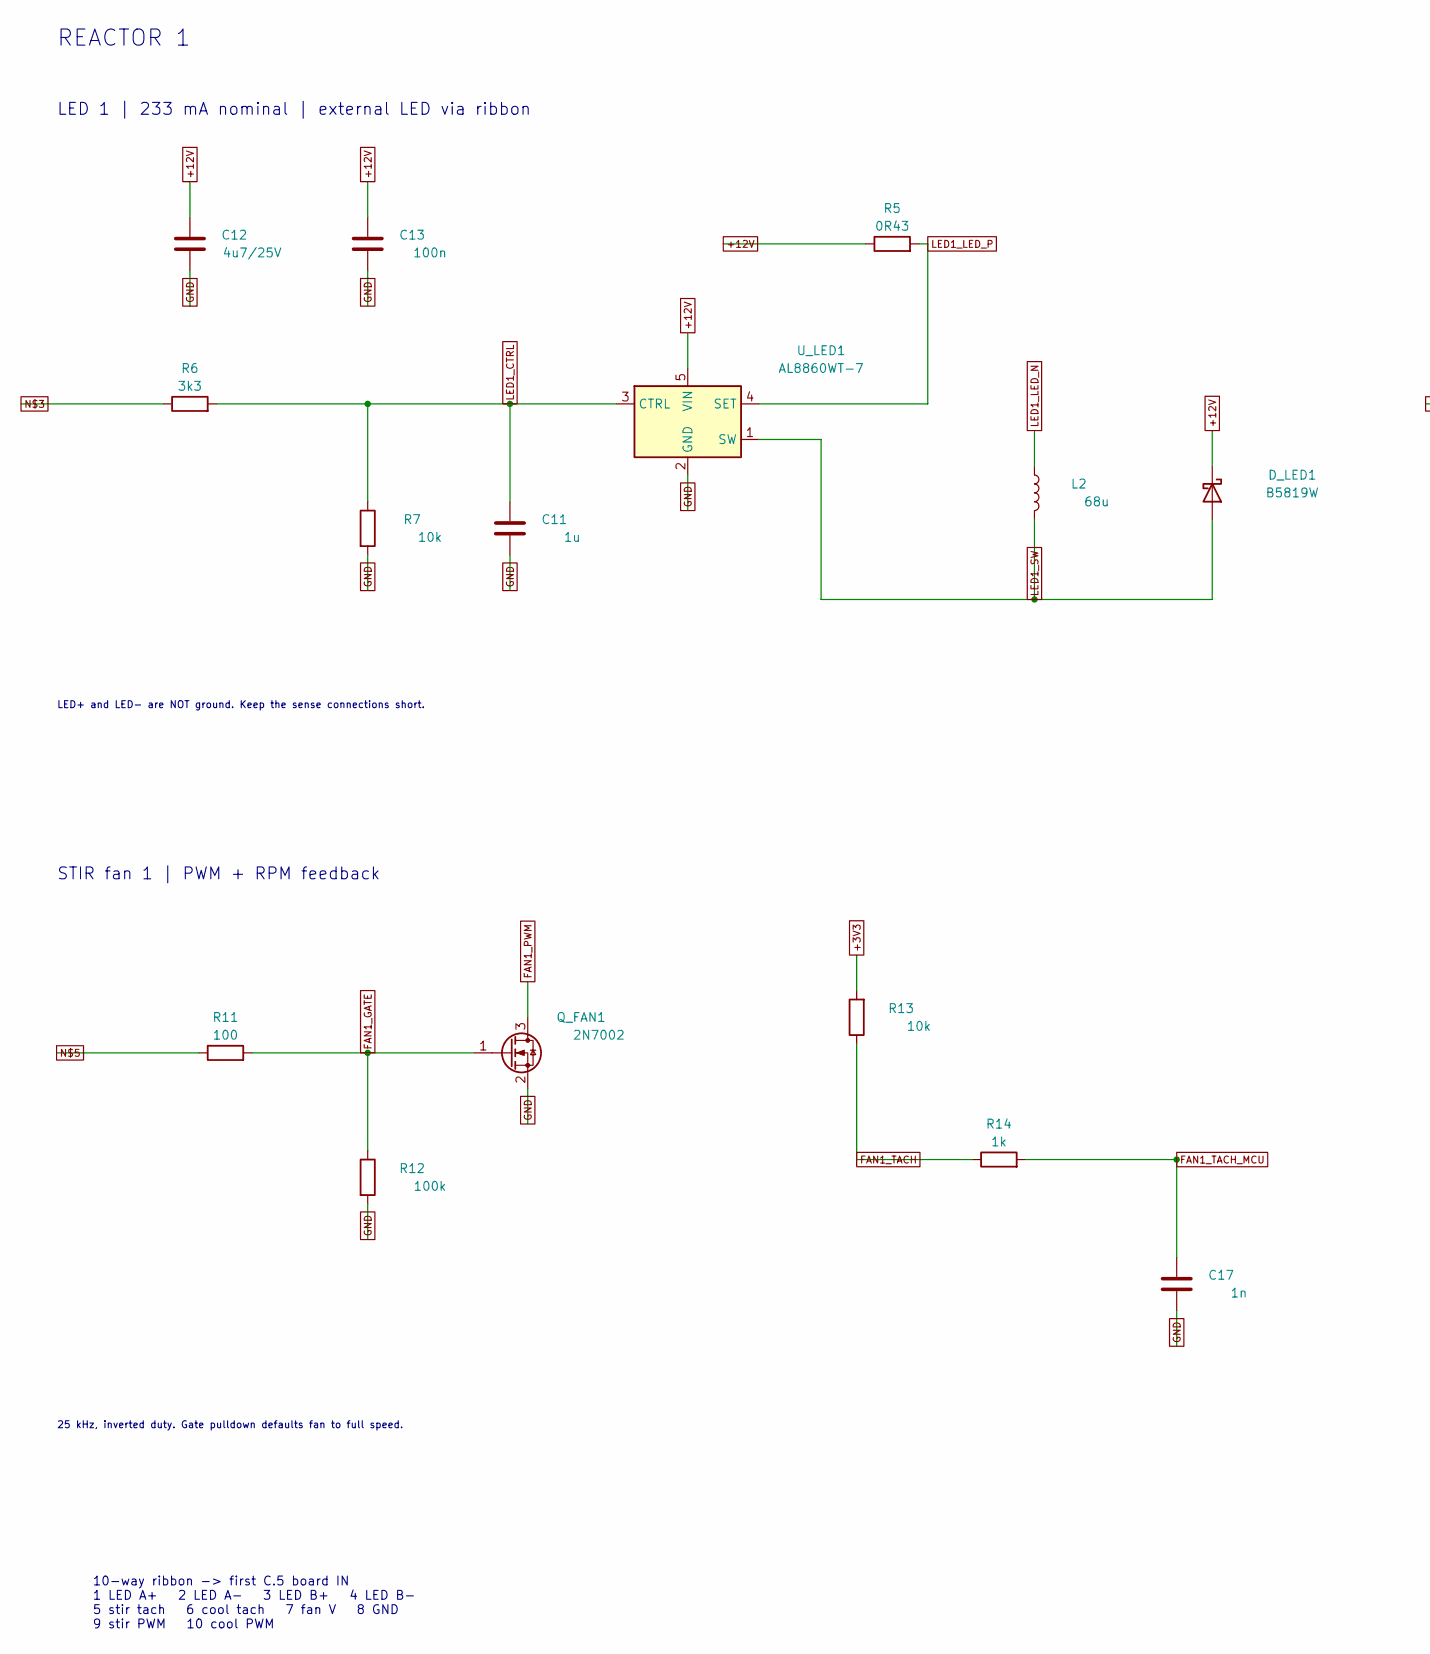
[picture p32: schematic photoreactor_quad_reactor_1.kicad_sch, Reactor 1 — LED and fan channels, part in row 1, column 1]

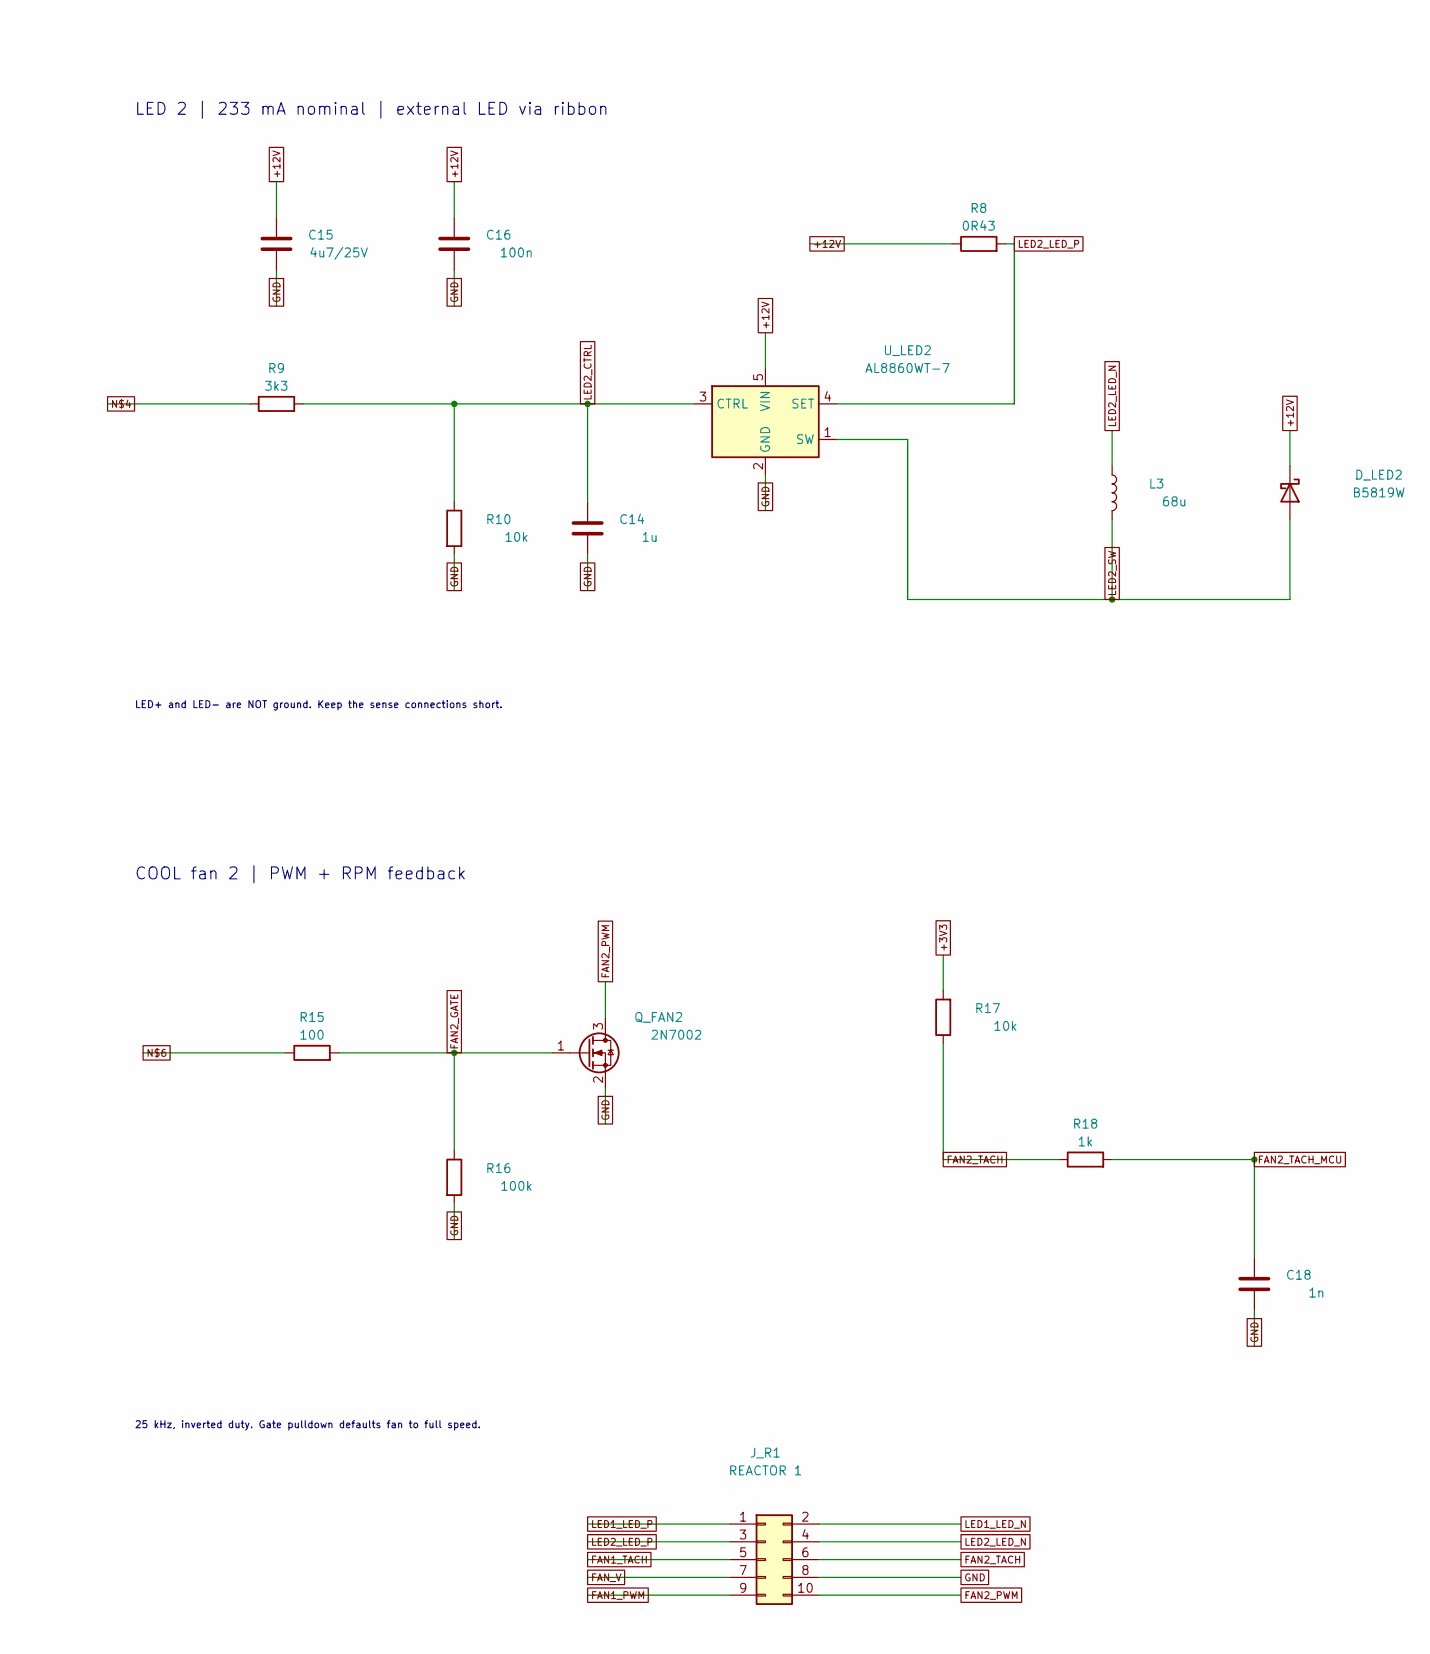
[picture p33: schematic photoreactor_quad_reactor_1.kicad_sch, Reactor 1 — LED and fan channels, part in row 1, column 2]

Parts:
C11, C14: 1u; C_0805_2012Metric; MPN CL21B105KBFNNNE; LCSC C28323
C12, C15: 4u7/25V; C_0805_2012Metric; MPN CL21A475KAQNNNE; LCSC C1779
C13, C16: 100n; C_0805_2012Metric; MPN CC0805KRX7R9BB104; LCSC C49678
C17, C18: 1n; C_0805_2012Metric; MPN CL21B102KCANNNC; LCSC C15177
D_LED1, D_LED2: B5819W; D_SOD-123; MPN B5819W SL
J_R1: REACTOR 1; JXT_IDC2.54_2X5P_A2; MPN JXT-IDC2.54-2X5P-A2
L2, L3: 68u; L_Bourns_SRN6045TA; MPN SRN6045TA-680M
Q_FAN1, Q_FAN2: 2N7002; SOT-23; MPN 2N7002
R5, R8: 0R43; R_1206_3216Metric; MPN CR1206FR430P05R
R6, R9: 3k3; R_0805_2012Metric; MPN 0805W8F3301T5E; LCSC C26010
R7, R10, R13, R17: 10k; R_0805_2012Metric; MPN 0805W8F1002T5E; LCSC C17414
R11, R15: 100; R_0805_2012Metric; MPN 0805W8F1000T5E; LCSC C17408
R12, R16: 100k; R_0805_2012Metric; MPN 0805W8F1003T5E; LCSC C149504
R14, R18: 1k; R_0805_2012Metric; MPN 0805W8F1001T5E; LCSC C17513
U_LED1, U_LED2: AL8860WT-7; SOT-23-5; MPN AL8860WT-7

Connections:
+3V3: R13.2, R17.2; also elsewhere on the board
+12V: C12.1, C13.1, C15.1, C16.1, D_LED1.1 (K), D_LED2.1 (K), R5.1, R8.1, U_LED1.5 (VIN), U_LED2.5 (VIN); also elsewhere on the board
FAN1_GATE: Q_FAN1.1 (G), R11.2, R12.1
FAN1_PWM: J_R1.9, Q_FAN1.3 (D)
FAN1_TACH: J_R1.5, R13.1, R14.1
FAN1_TACH_MCU: C17.1, R14.2; also elsewhere on the board
FAN2_GATE: Q_FAN2.1 (G), R15.2, R16.1
FAN2_PWM: J_R1.10, Q_FAN2.3 (D)
FAN2_TACH: J_R1.6, R17.1, R18.1
FAN2_TACH_MCU: C18.1, R18.2; also elsewhere on the board
FAN_V: J_R1.7; also elsewhere on the board
GND: C11.2, C12.2, C13.2, C14.2, C15.2, C16.2, C17.2, C18.2, J_R1.8, Q_FAN1.2 (S), Q_FAN2.2 (S), R7.2, R10.2, R12.2, R16.2, U_LED1.2 (GND), U_LED2.2 (GND); also elsewhere on the board
LED1_CTRL: C11.1, R6.2, R7.1, U_LED1.3 (CTRL)
LED1_LED_N: J_R1.2, L2.1
LED1_LED_P: J_R1.1, R5.2, U_LED1.4 (SET)
LED1_SW: D_LED1.2 (A), L2.2, U_LED1.1 (SW)
LED2_CTRL: C14.1, R9.2, R10.1, U_LED2.3 (CTRL)
LED2_LED_N: J_R1.4, L3.1
LED2_LED_P: J_R1.3, R8.2, U_LED2.4 (SET)
LED2_SW: D_LED2.2 (A), L3.2, U_LED2.1 (SW)
unnamed 73: R6.1; also elsewhere on the board
unnamed 74: R9.1; also elsewhere on the board
unnamed 75: R11.1; also elsewhere on the board
unnamed 76: R15.1; also elsewhere on the board

Notes on the sheet:
REACTOR 1
LED 1 | 233 mA nominal | external LED via ribbon
LED+ and LED- are NOT ground. Keep the sense connections short.
LED 2 | 233 mA nominal | external LED via ribbon
STIR fan 1 | PWM + RPM feedback
25 kHz, inverted duty. Gate pulldown defaults fan to full speed.
COOL fan 2 | PWM + RPM feedback
10-way ribbon -> first C.5 board IN 1 LED A+ 2 LED A- 3 LED B+ 4 LED B- 5 stir tach 6 cool tach 7 fan V 8 GND 9 stir PWM 10 cool PWM

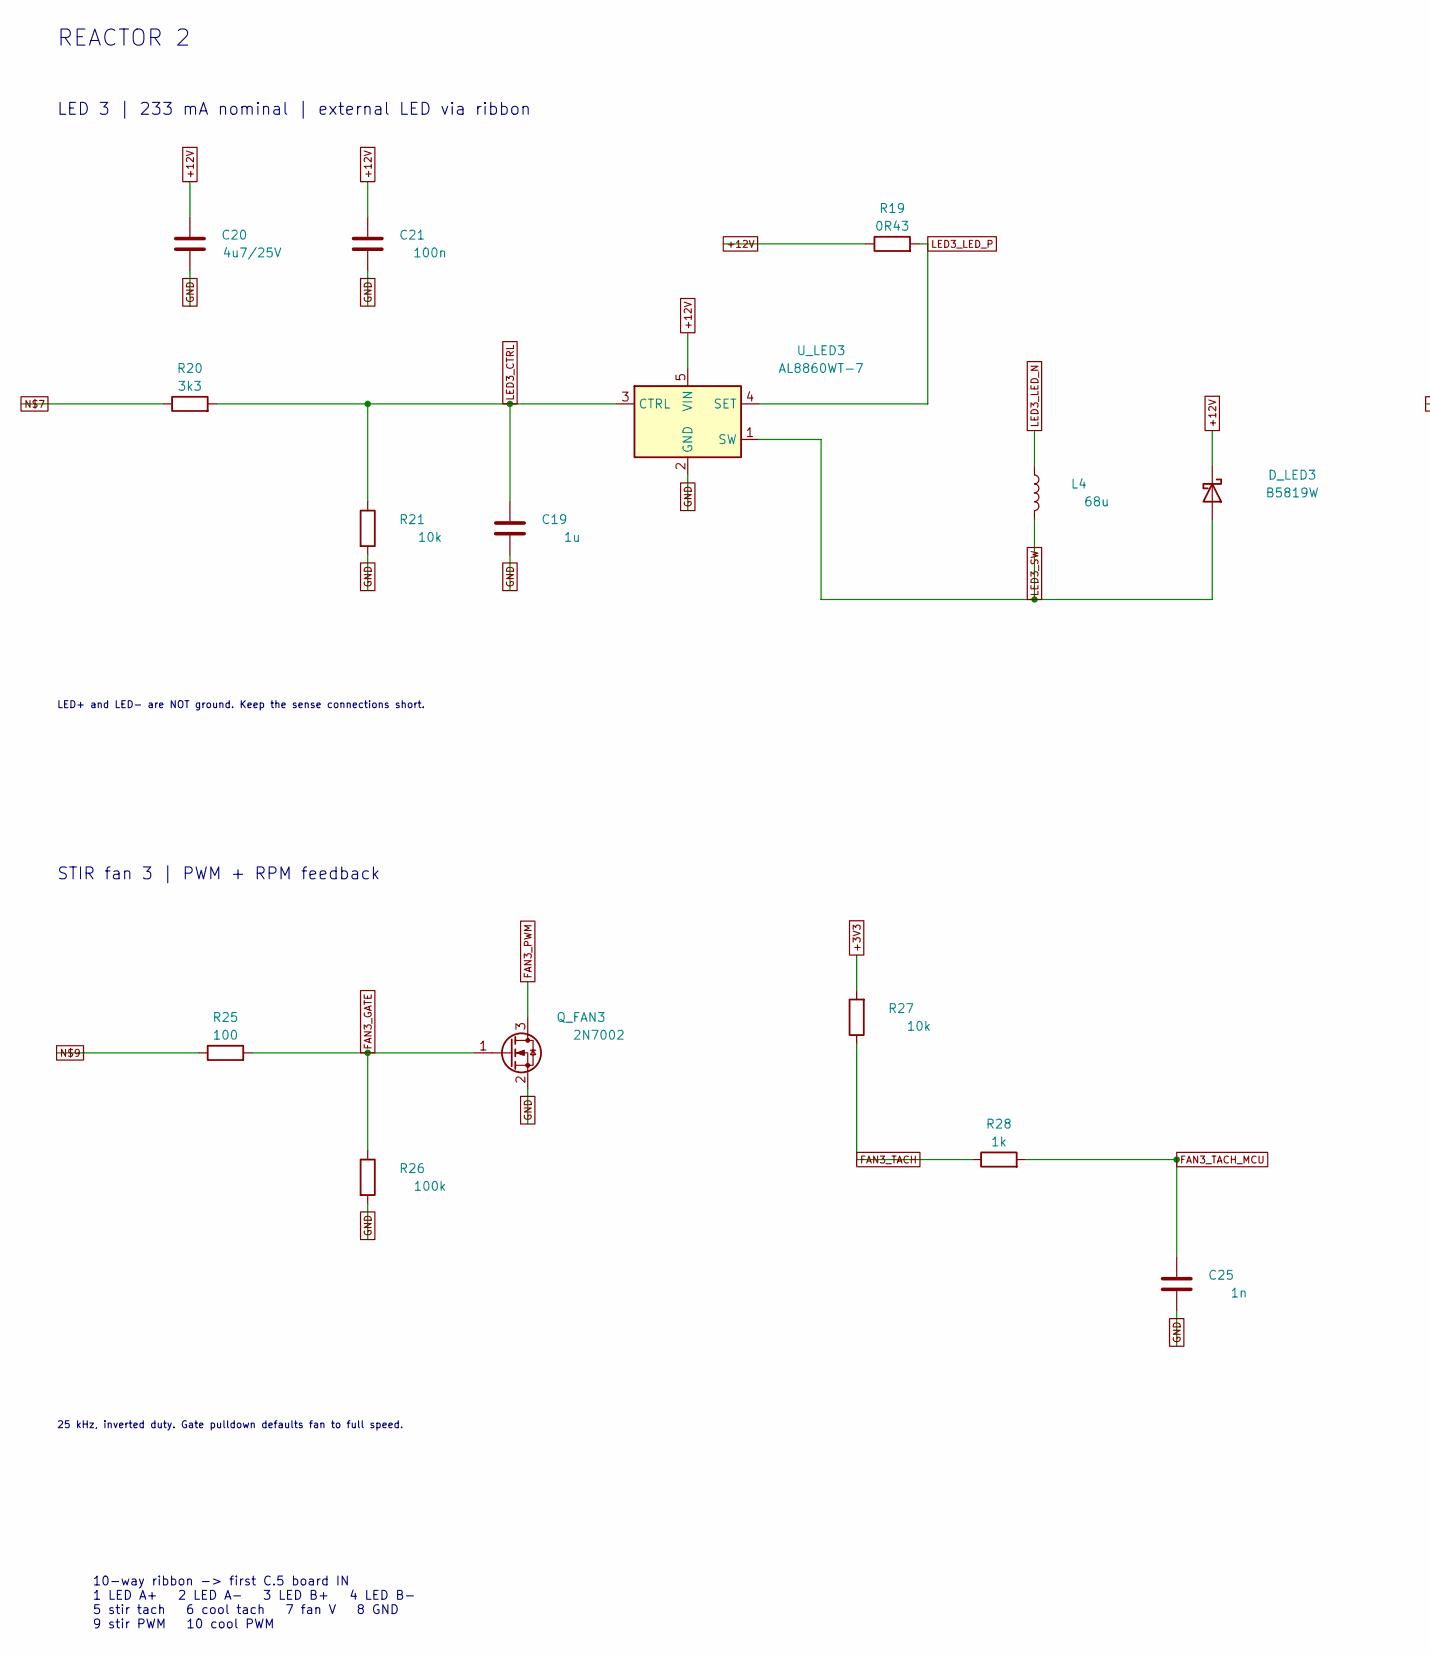
[picture p34: schematic photoreactor_quad_reactor_2.kicad_sch, Reactor 2 — LED and fan channels, part in row 1, column 1]

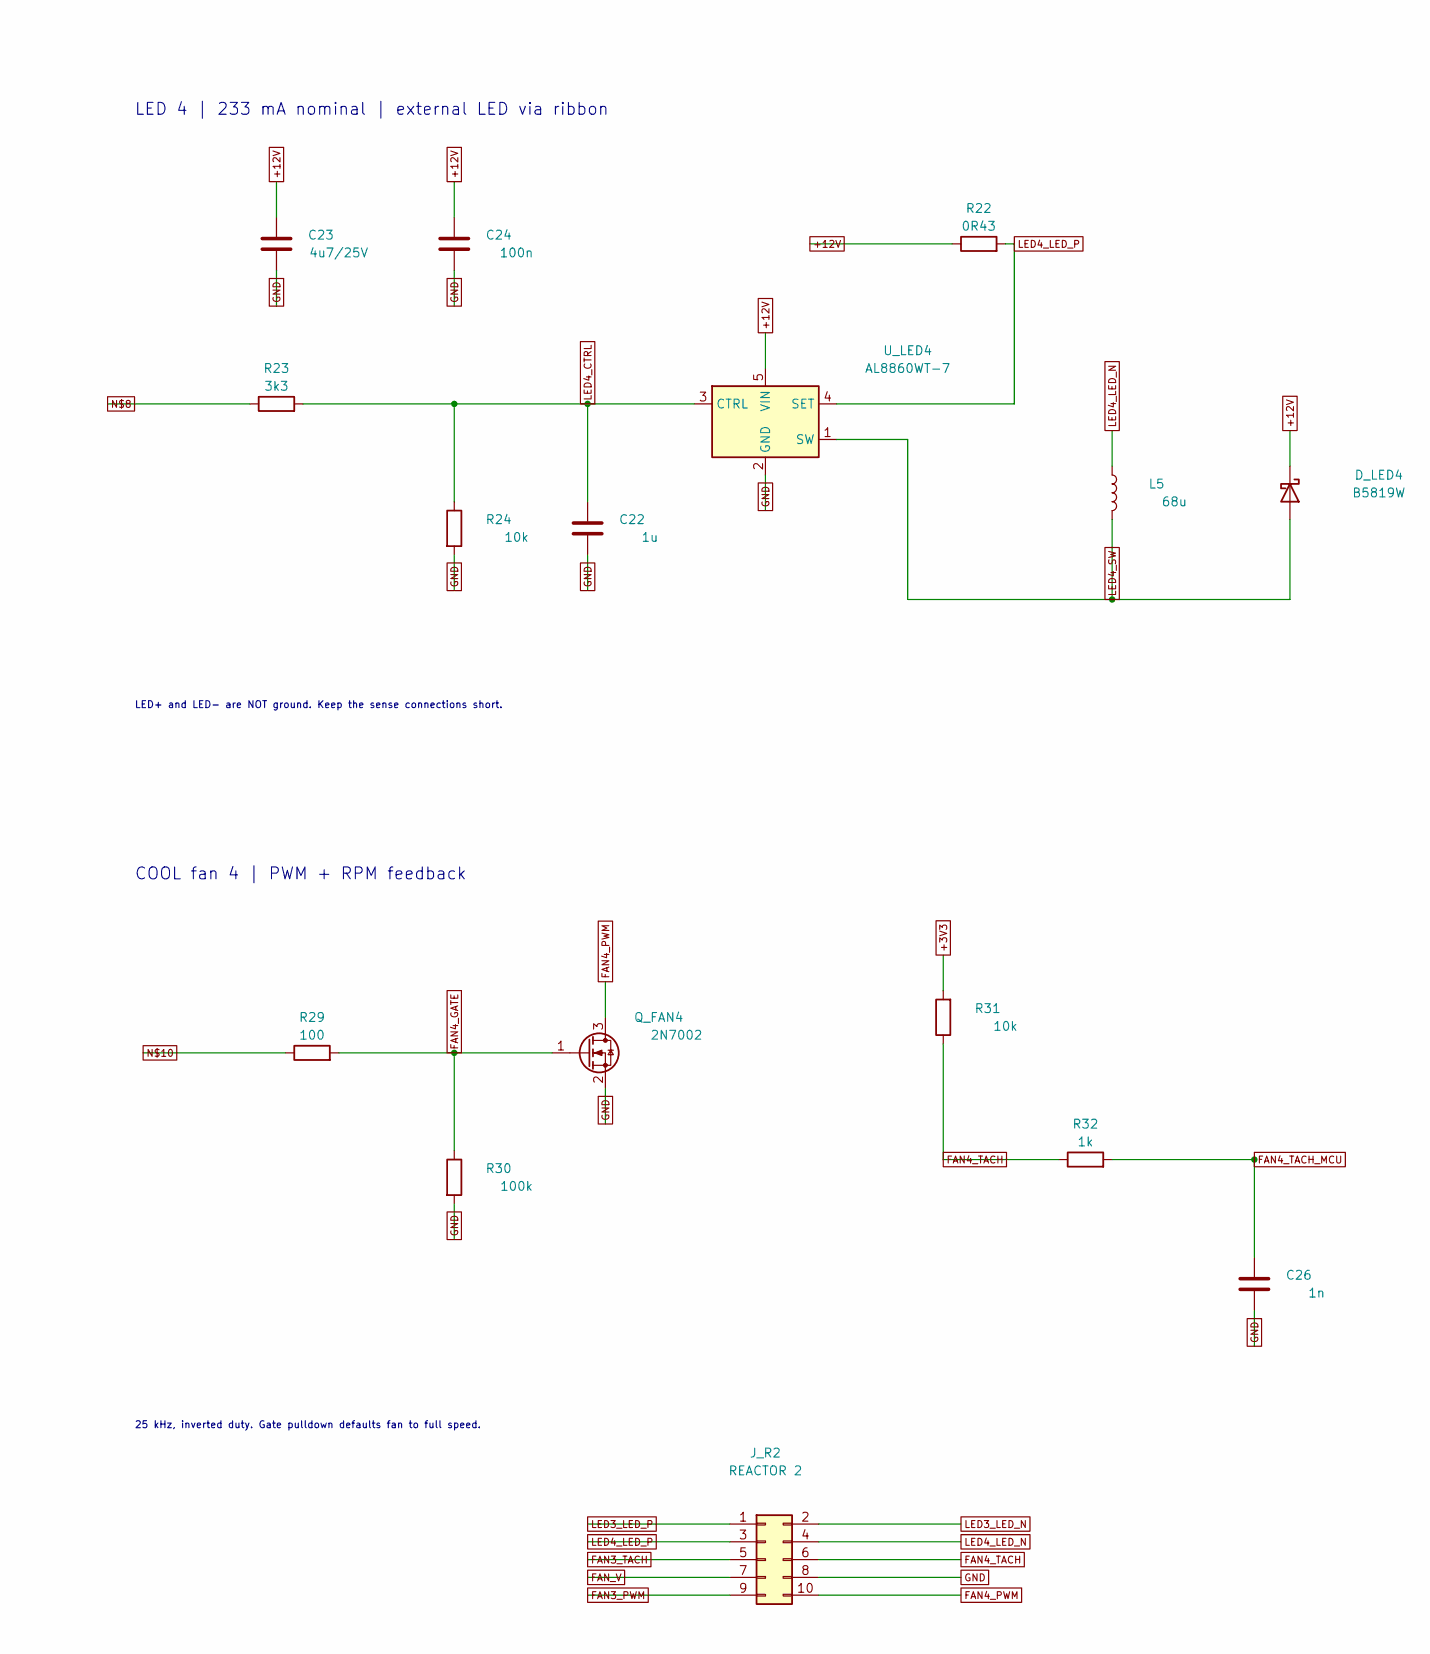
[picture p35: schematic photoreactor_quad_reactor_2.kicad_sch, Reactor 2 — LED and fan channels, part in row 1, column 2]

Parts:
C19, C22: 1u; C_0805_2012Metric; MPN CL21B105KBFNNNE; LCSC C28323
C20, C23: 4u7/25V; C_0805_2012Metric; MPN CL21A475KAQNNNE; LCSC C1779
C21, C24: 100n; C_0805_2012Metric; MPN CC0805KRX7R9BB104; LCSC C49678
C25, C26: 1n; C_0805_2012Metric; MPN CL21B102KCANNNC; LCSC C15177
D_LED3, D_LED4: B5819W; D_SOD-123; MPN B5819W SL
J_R2: REACTOR 2; JXT_IDC2.54_2X5P_A2; MPN JXT-IDC2.54-2X5P-A2
L4, L5: 68u; L_Bourns_SRN6045TA; MPN SRN6045TA-680M
Q_FAN3, Q_FAN4: 2N7002; SOT-23; MPN 2N7002
R19, R22: 0R43; R_1206_3216Metric; MPN CR1206FR430P05R
R20, R23: 3k3; R_0805_2012Metric; MPN 0805W8F3301T5E; LCSC C26010
R21, R24, R27, R31: 10k; R_0805_2012Metric; MPN 0805W8F1002T5E; LCSC C17414
R25, R29: 100; R_0805_2012Metric; MPN 0805W8F1000T5E; LCSC C17408
R26, R30: 100k; R_0805_2012Metric; MPN 0805W8F1003T5E; LCSC C149504
R28, R32: 1k; R_0805_2012Metric; MPN 0805W8F1001T5E; LCSC C17513
U_LED3, U_LED4: AL8860WT-7; SOT-23-5; MPN AL8860WT-7

Connections:
+3V3: R27.2, R31.2; also elsewhere on the board
+12V: C20.1, C21.1, C23.1, C24.1, D_LED3.1 (K), D_LED4.1 (K), R19.1, R22.1, U_LED3.5 (VIN), U_LED4.5 (VIN); also elsewhere on the board
FAN3_GATE: Q_FAN3.1 (G), R25.2, R26.1
FAN3_PWM: J_R2.9, Q_FAN3.3 (D)
FAN3_TACH: J_R2.5, R27.1, R28.1
FAN3_TACH_MCU: C25.1, R28.2; also elsewhere on the board
FAN4_GATE: Q_FAN4.1 (G), R29.2, R30.1
FAN4_PWM: J_R2.10, Q_FAN4.3 (D)
FAN4_TACH: J_R2.6, R31.1, R32.1
FAN4_TACH_MCU: C26.1, R32.2; also elsewhere on the board
FAN_V: J_R2.7; also elsewhere on the board
GND: C19.2, C20.2, C21.2, C22.2, C23.2, C24.2, C25.2, C26.2, J_R2.8, Q_FAN3.2 (S), Q_FAN4.2 (S), R21.2, R24.2, R26.2, R30.2, U_LED3.2 (GND), U_LED4.2 (GND); also elsewhere on the board
LED3_CTRL: C19.1, R20.2, R21.1, U_LED3.3 (CTRL)
LED3_LED_N: J_R2.2, L4.1
LED3_LED_P: J_R2.1, R19.2, U_LED3.4 (SET)
LED3_SW: D_LED3.2 (A), L4.2, U_LED3.1 (SW)
LED4_CTRL: C22.1, R23.2, R24.1, U_LED4.3 (CTRL)
LED4_LED_N: J_R2.4, L5.1
LED4_LED_P: J_R2.3, R22.2, U_LED4.4 (SET)
LED4_SW: D_LED4.2 (A), L5.2, U_LED4.1 (SW)
unnamed 77: R20.1; also elsewhere on the board
unnamed 78: R23.1; also elsewhere on the board
unnamed 79: R25.1; also elsewhere on the board
unnamed 80: R29.1; also elsewhere on the board

Notes on the sheet:
REACTOR 2
LED 3 | 233 mA nominal | external LED via ribbon
LED+ and LED- are NOT ground. Keep the sense connections short.
LED 4 | 233 mA nominal | external LED via ribbon
STIR fan 3 | PWM + RPM feedback
25 kHz, inverted duty. Gate pulldown defaults fan to full speed.
COOL fan 4 | PWM + RPM feedback
10-way ribbon -> first C.5 board IN 1 LED A+ 2 LED A- 3 LED B+ 4 LED B- 5 stir tach 6 cool tach 7 fan V 8 GND 9 stir PWM 10 cool PWM

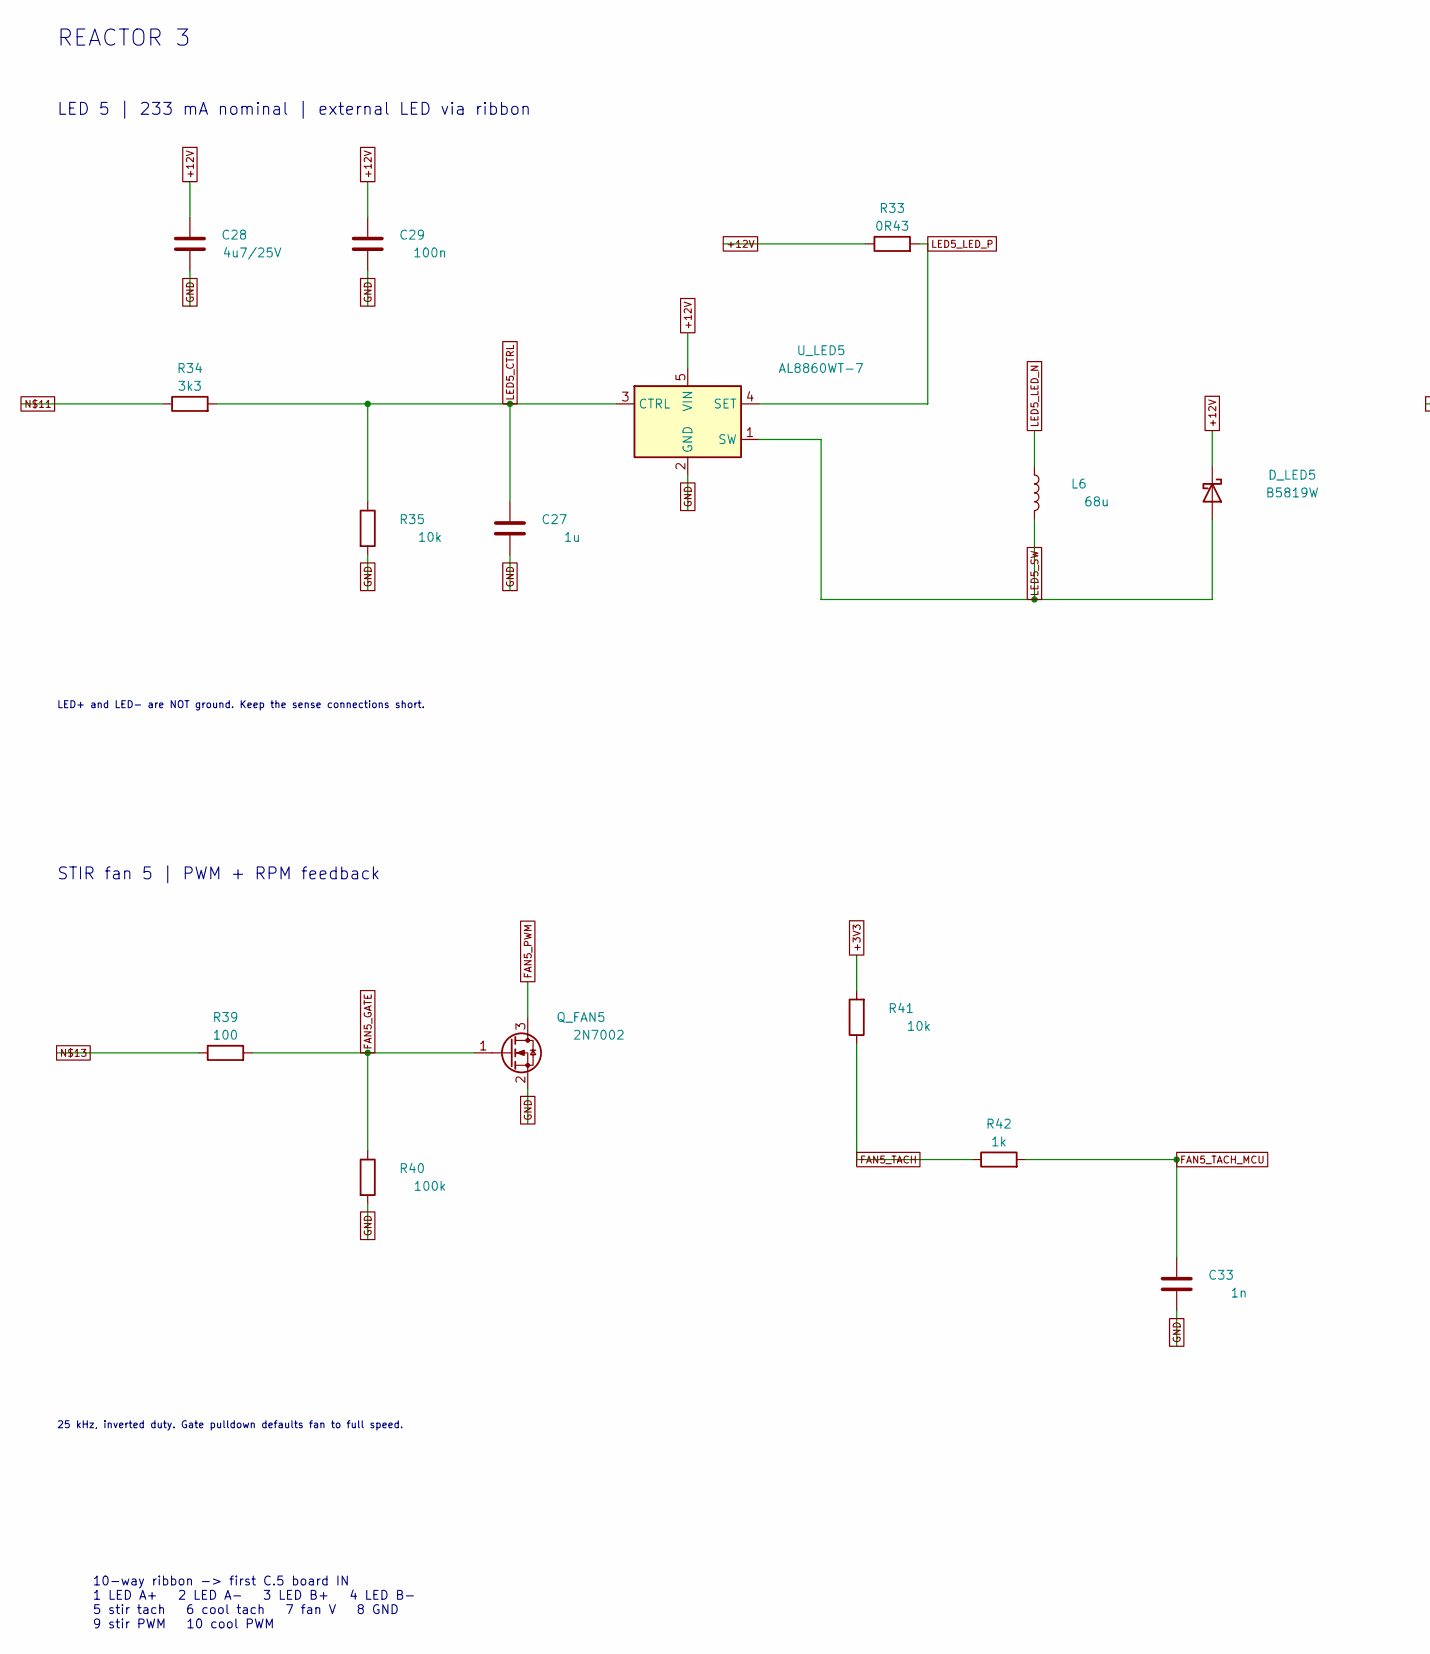
[picture p36: schematic photoreactor_quad_reactor_3.kicad_sch, Reactor 3 — LED and fan channels, part in row 1, column 1]

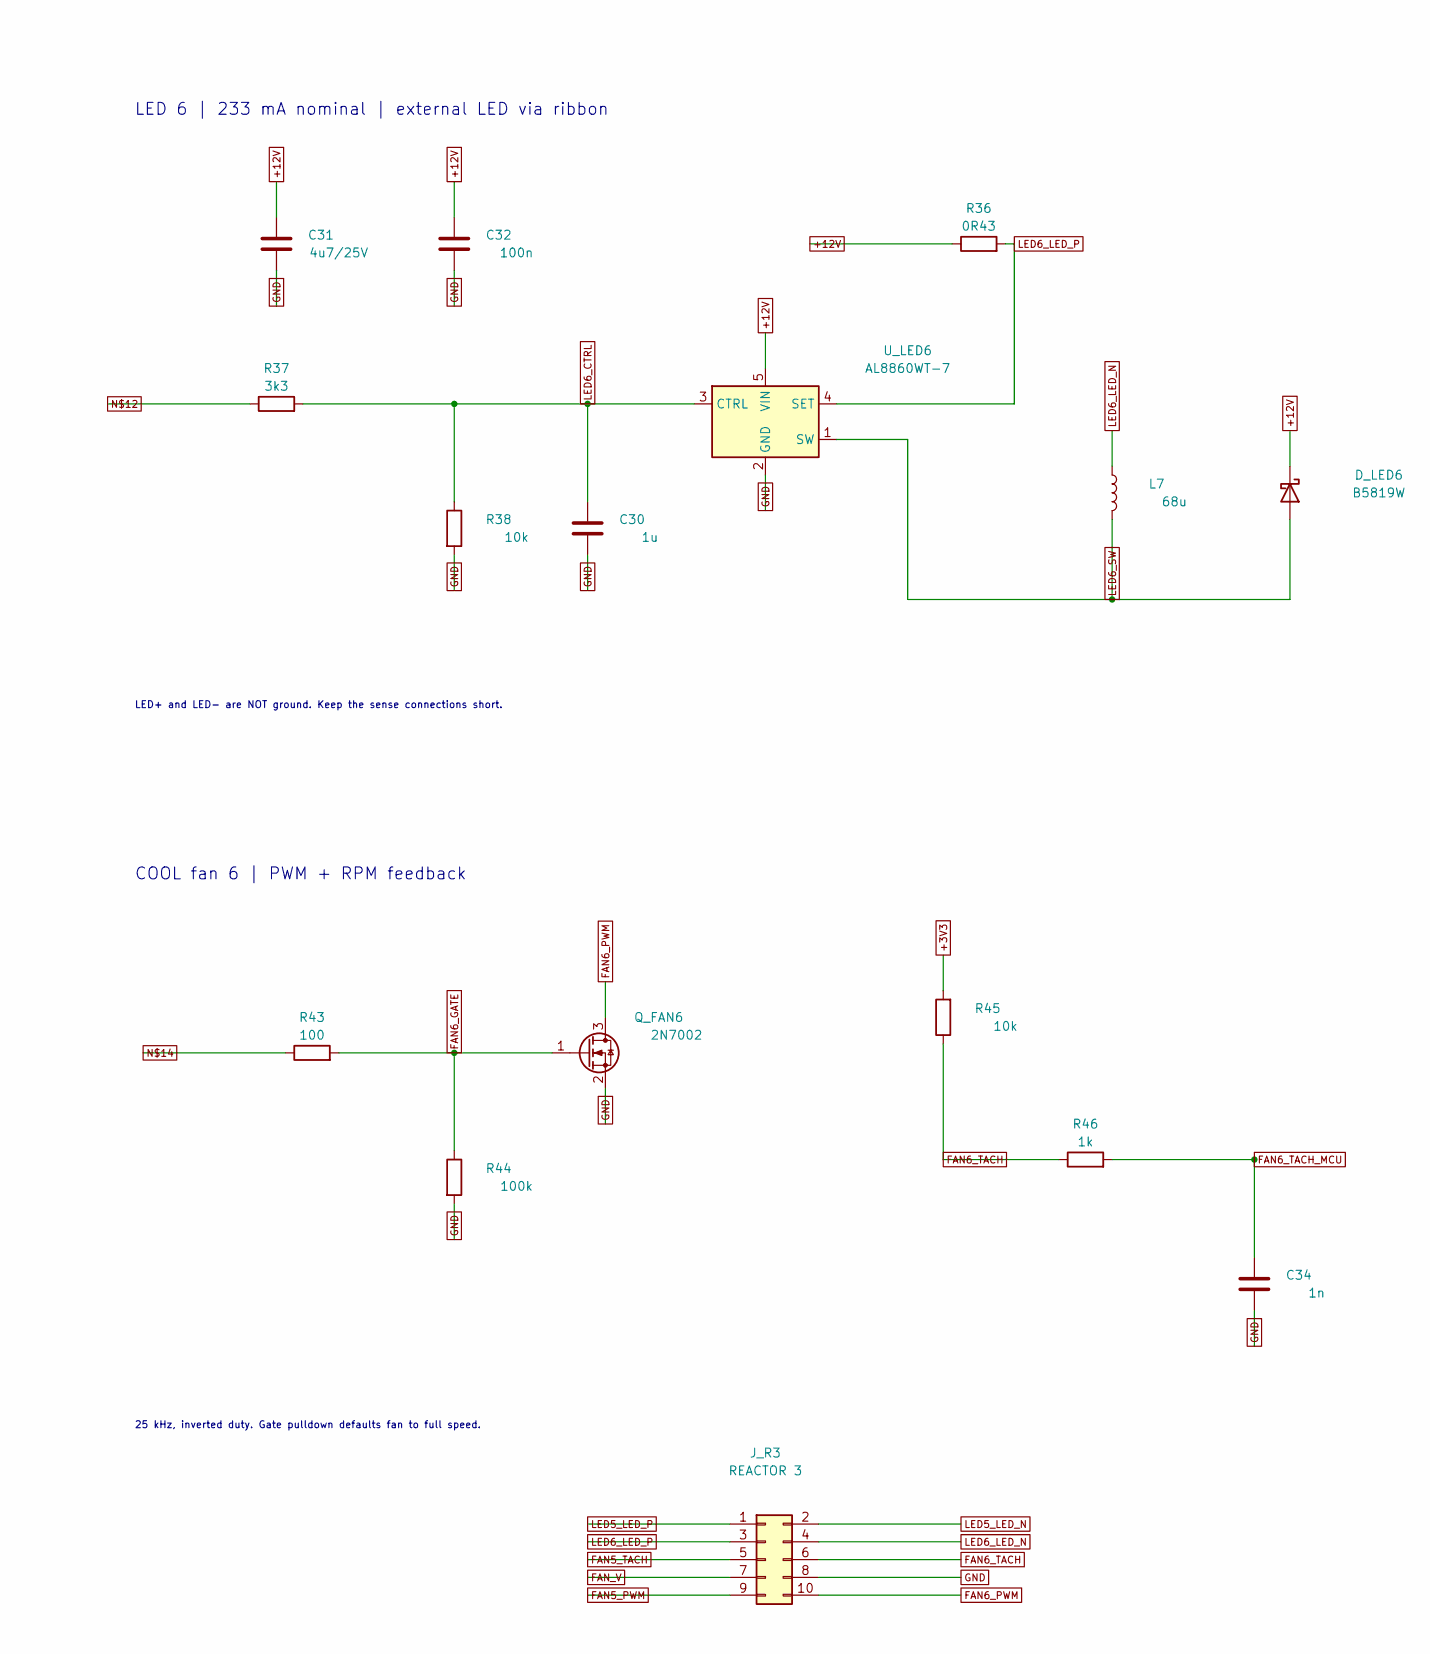
[picture p37: schematic photoreactor_quad_reactor_3.kicad_sch, Reactor 3 — LED and fan channels, part in row 1, column 2]

Parts:
C27, C30: 1u; C_0805_2012Metric; MPN CL21B105KBFNNNE; LCSC C28323
C28, C31: 4u7/25V; C_0805_2012Metric; MPN CL21A475KAQNNNE; LCSC C1779
C29, C32: 100n; C_0805_2012Metric; MPN CC0805KRX7R9BB104; LCSC C49678
C33, C34: 1n; C_0805_2012Metric; MPN CL21B102KCANNNC; LCSC C15177
D_LED5, D_LED6: B5819W; D_SOD-123; MPN B5819W SL
J_R3: REACTOR 3; JXT_IDC2.54_2X5P_A2; MPN JXT-IDC2.54-2X5P-A2
L6, L7: 68u; L_Bourns_SRN6045TA; MPN SRN6045TA-680M
Q_FAN5, Q_FAN6: 2N7002; SOT-23; MPN 2N7002
R33, R36: 0R43; R_1206_3216Metric; MPN CR1206FR430P05R
R34, R37: 3k3; R_0805_2012Metric; MPN 0805W8F3301T5E; LCSC C26010
R35, R38, R41, R45: 10k; R_0805_2012Metric; MPN 0805W8F1002T5E; LCSC C17414
R39, R43: 100; R_0805_2012Metric; MPN 0805W8F1000T5E; LCSC C17408
R40, R44: 100k; R_0805_2012Metric; MPN 0805W8F1003T5E; LCSC C149504
R42, R46: 1k; R_0805_2012Metric; MPN 0805W8F1001T5E; LCSC C17513
U_LED5, U_LED6: AL8860WT-7; SOT-23-5; MPN AL8860WT-7

Connections:
+3V3: R41.2, R45.2; also elsewhere on the board
+12V: C28.1, C29.1, C31.1, C32.1, D_LED5.1 (K), D_LED6.1 (K), R33.1, R36.1, U_LED5.5 (VIN), U_LED6.5 (VIN); also elsewhere on the board
FAN5_GATE: Q_FAN5.1 (G), R39.2, R40.1
FAN5_PWM: J_R3.9, Q_FAN5.3 (D)
FAN5_TACH: J_R3.5, R41.1, R42.1
FAN5_TACH_MCU: C33.1, R42.2; also elsewhere on the board
FAN6_GATE: Q_FAN6.1 (G), R43.2, R44.1
FAN6_PWM: J_R3.10, Q_FAN6.3 (D)
FAN6_TACH: J_R3.6, R45.1, R46.1
FAN6_TACH_MCU: C34.1, R46.2; also elsewhere on the board
FAN_V: J_R3.7; also elsewhere on the board
GND: C27.2, C28.2, C29.2, C30.2, C31.2, C32.2, C33.2, C34.2, J_R3.8, Q_FAN5.2 (S), Q_FAN6.2 (S), R35.2, R38.2, R40.2, R44.2, U_LED5.2 (GND), U_LED6.2 (GND); also elsewhere on the board
LED5_CTRL: C27.1, R34.2, R35.1, U_LED5.3 (CTRL)
LED5_LED_N: J_R3.2, L6.1
LED5_LED_P: J_R3.1, R33.2, U_LED5.4 (SET)
LED5_SW: D_LED5.2 (A), L6.2, U_LED5.1 (SW)
LED6_CTRL: C30.1, R37.2, R38.1, U_LED6.3 (CTRL)
LED6_LED_N: J_R3.4, L7.1
LED6_LED_P: J_R3.3, R36.2, U_LED6.4 (SET)
LED6_SW: D_LED6.2 (A), L7.2, U_LED6.1 (SW)
unnamed 81: R34.1; also elsewhere on the board
unnamed 82: R37.1; also elsewhere on the board
unnamed 83: R39.1; also elsewhere on the board
unnamed 84: R43.1; also elsewhere on the board

Notes on the sheet:
REACTOR 3
LED 5 | 233 mA nominal | external LED via ribbon
LED+ and LED- are NOT ground. Keep the sense connections short.
LED 6 | 233 mA nominal | external LED via ribbon
STIR fan 5 | PWM + RPM feedback
25 kHz, inverted duty. Gate pulldown defaults fan to full speed.
COOL fan 6 | PWM + RPM feedback
10-way ribbon -> first C.5 board IN 1 LED A+ 2 LED A- 3 LED B+ 4 LED B- 5 stir tach 6 cool tach 7 fan V 8 GND 9 stir PWM 10 cool PWM
