kelvinchow23/photo-reactor/electrical/designs/controller/photoreactor_quad.kicad_pcb

## KiCad design electrical/designs/controller/photoreactor_quad.kicad_pcb (continued)

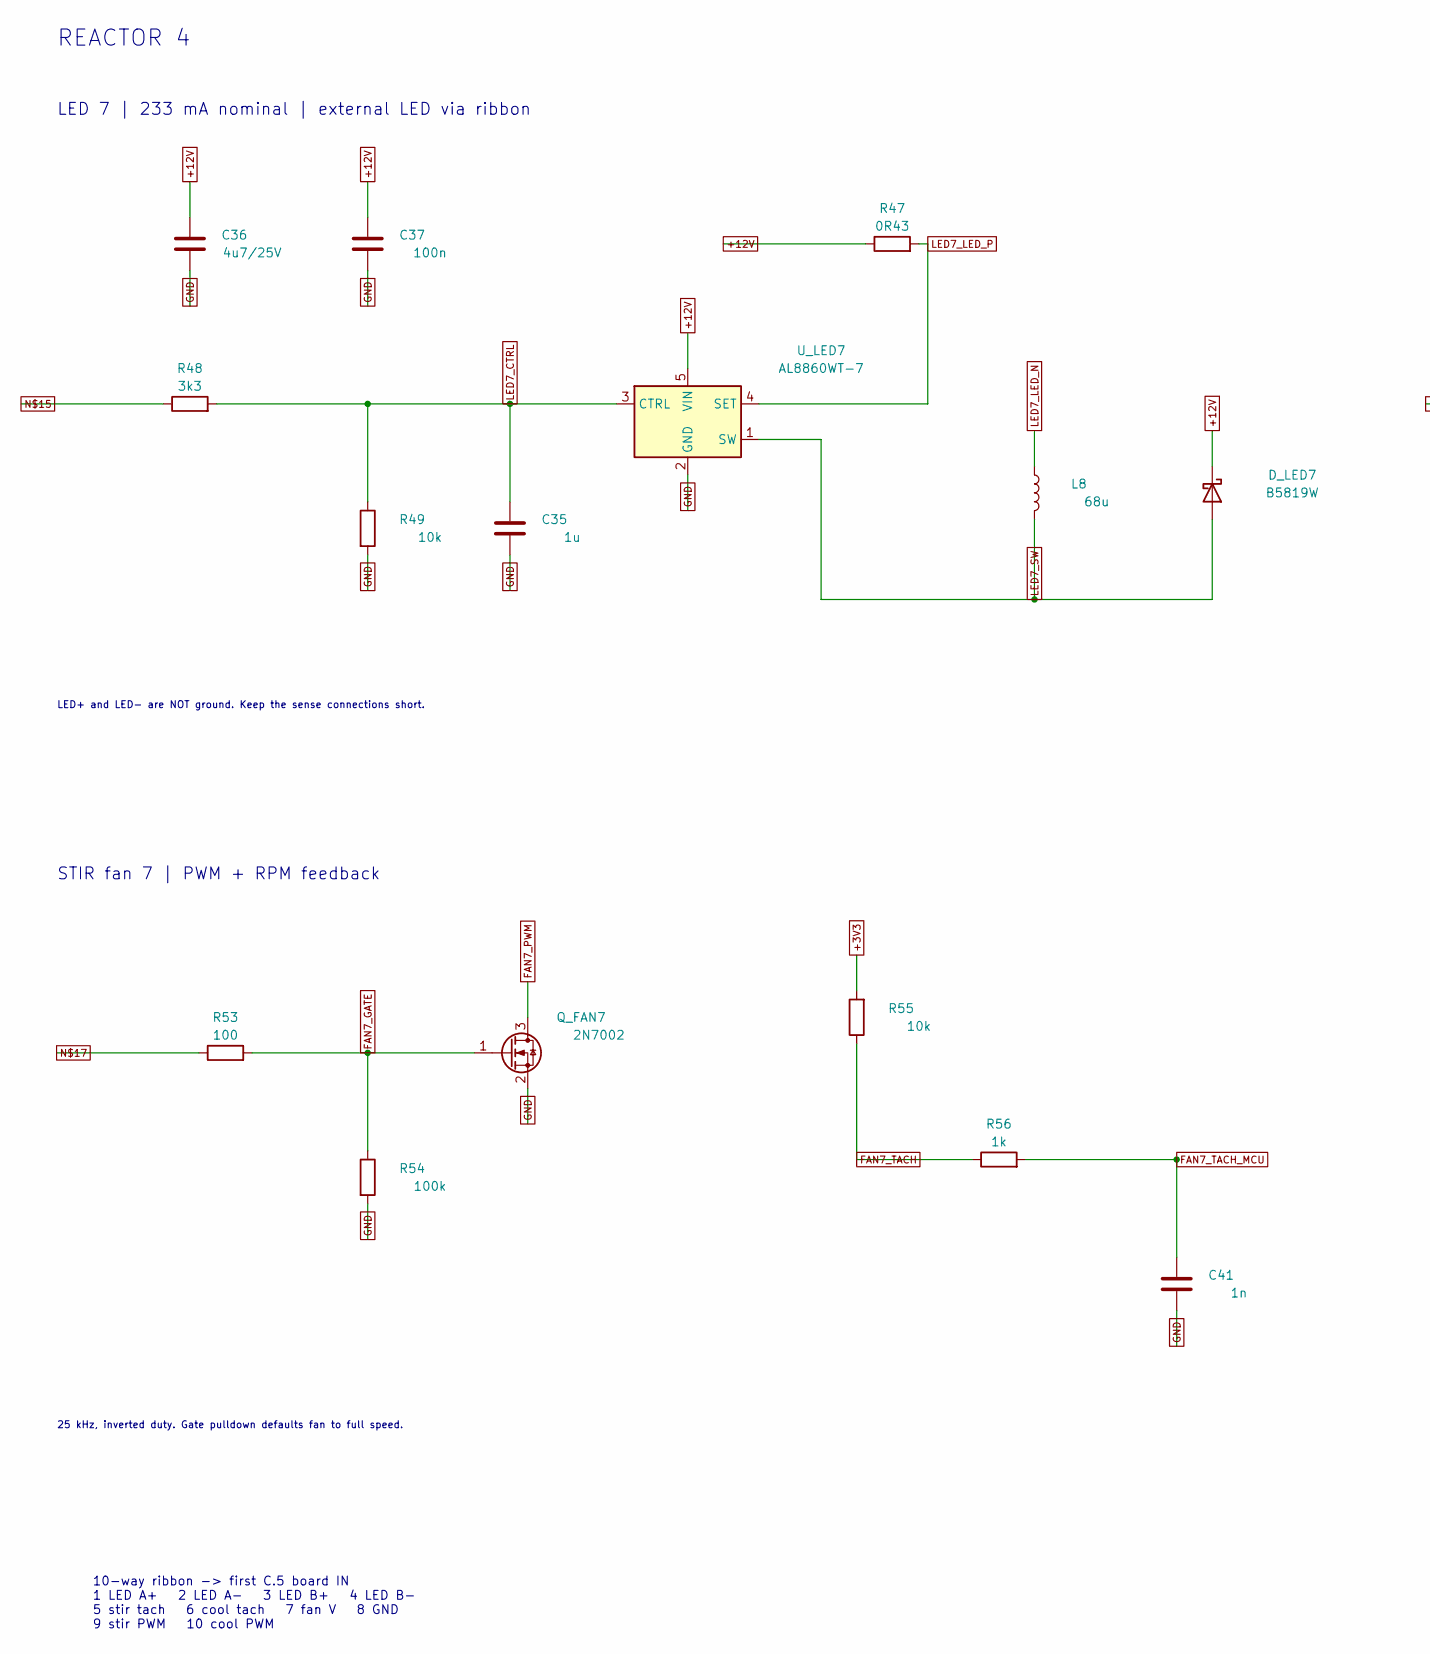
[picture p38: schematic photoreactor_quad_reactor_4.kicad_sch, Reactor 4 — LED and fan channels, part in row 1, column 1]

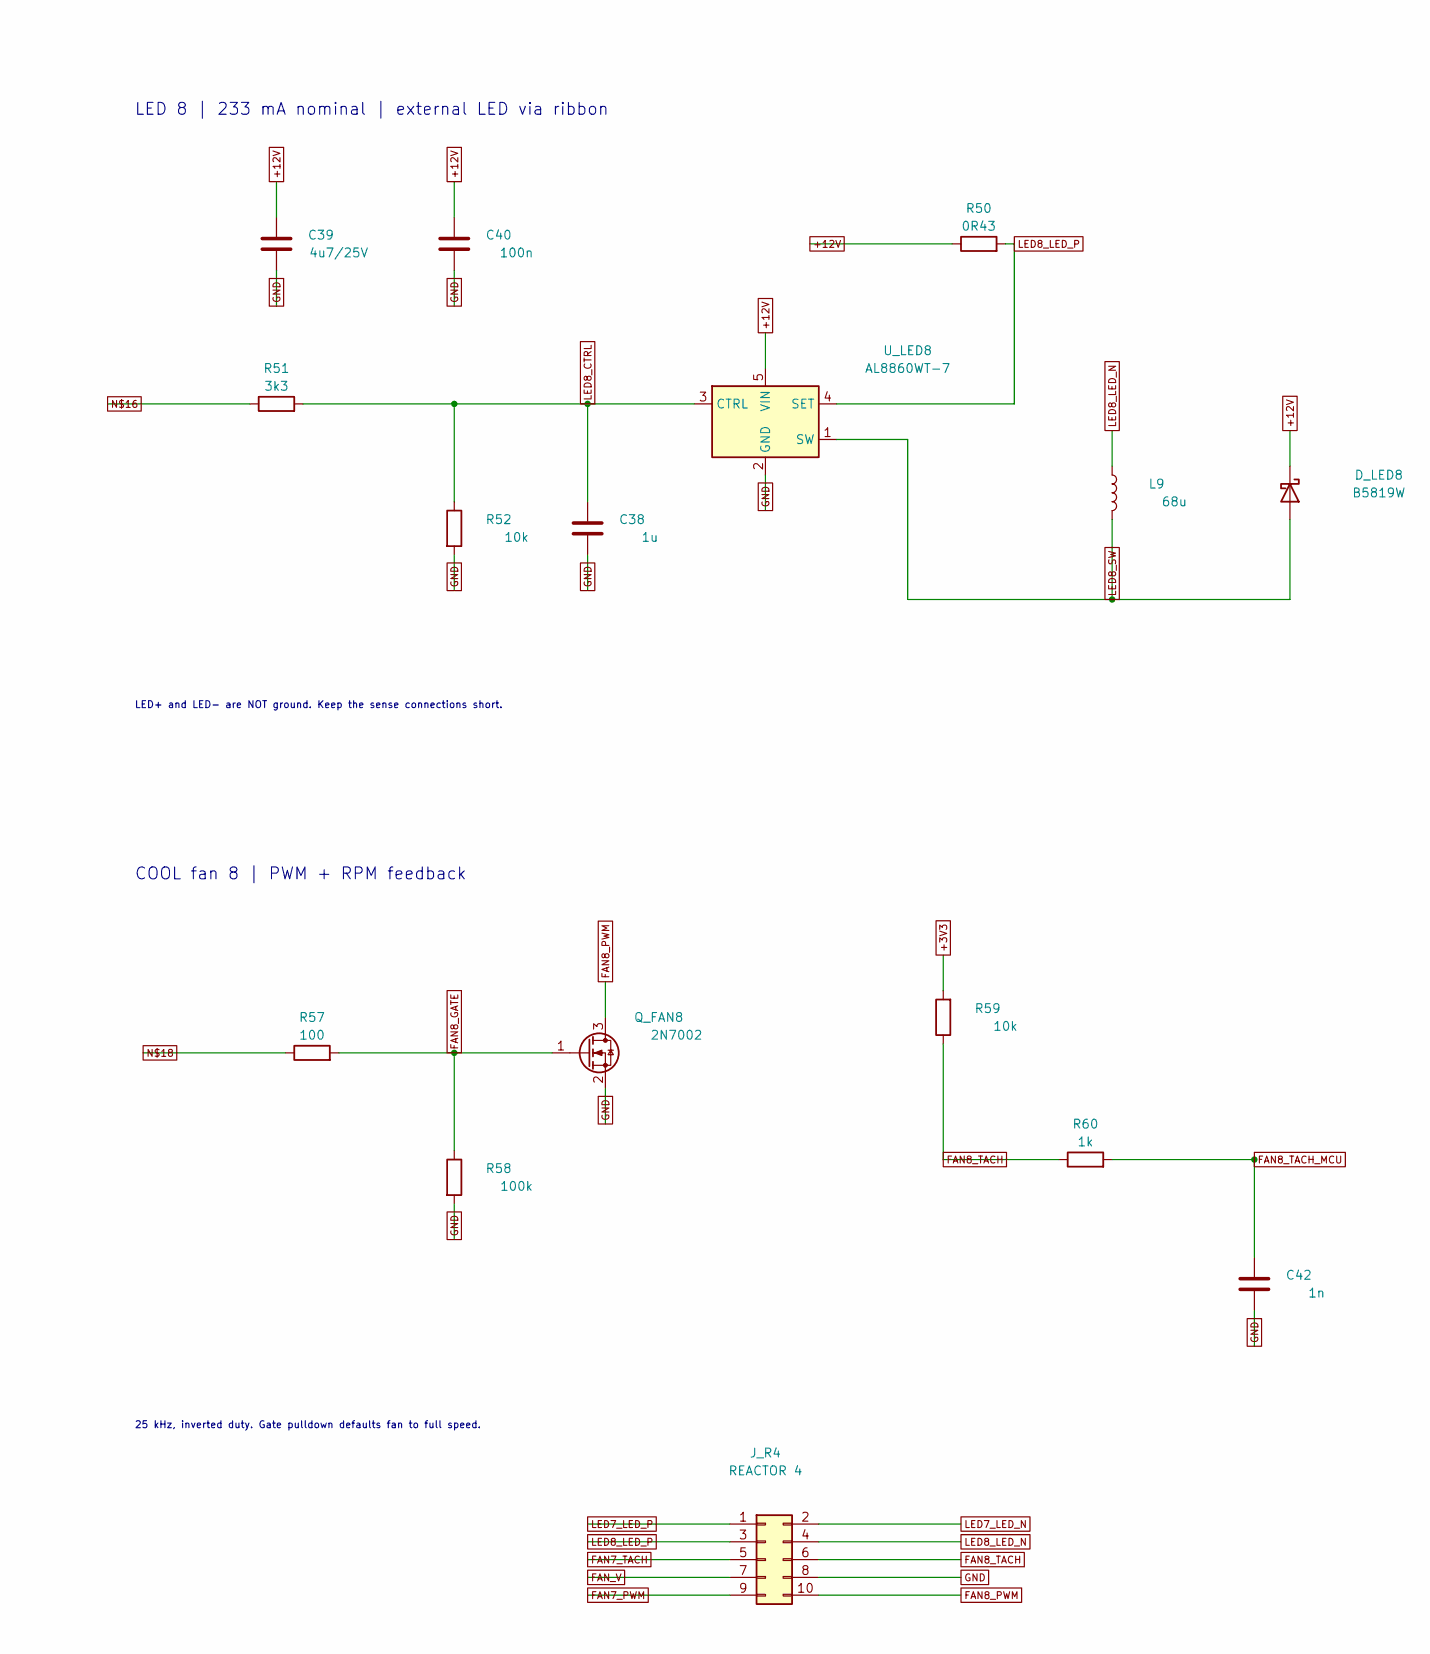
[picture p39: schematic photoreactor_quad_reactor_4.kicad_sch, Reactor 4 — LED and fan channels, part in row 1, column 2]

Parts:
C35, C38: 1u; C_0805_2012Metric; MPN CL21B105KBFNNNE; LCSC C28323
C36, C39: 4u7/25V; C_0805_2012Metric; MPN CL21A475KAQNNNE; LCSC C1779
C37, C40: 100n; C_0805_2012Metric; MPN CC0805KRX7R9BB104; LCSC C49678
C41, C42: 1n; C_0805_2012Metric; MPN CL21B102KCANNNC; LCSC C15177
D_LED7, D_LED8: B5819W; D_SOD-123; MPN B5819W SL
J_R4: REACTOR 4; JXT_IDC2.54_2X5P_A2; MPN JXT-IDC2.54-2X5P-A2
L8, L9: 68u; L_Bourns_SRN6045TA; MPN SRN6045TA-680M
Q_FAN7, Q_FAN8: 2N7002; SOT-23; MPN 2N7002
R47, R50: 0R43; R_1206_3216Metric; MPN CR1206FR430P05R
R48, R51: 3k3; R_0805_2012Metric; MPN 0805W8F3301T5E; LCSC C26010
R49, R52, R55, R59: 10k; R_0805_2012Metric; MPN 0805W8F1002T5E; LCSC C17414
R53, R57: 100; R_0805_2012Metric; MPN 0805W8F1000T5E; LCSC C17408
R54, R58: 100k; R_0805_2012Metric; MPN 0805W8F1003T5E; LCSC C149504
R56, R60: 1k; R_0805_2012Metric; MPN 0805W8F1001T5E; LCSC C17513
U_LED7, U_LED8: AL8860WT-7; SOT-23-5; MPN AL8860WT-7

Connections:
+3V3: R55.2, R59.2; also elsewhere on the board
+12V: C36.1, C37.1, C39.1, C40.1, D_LED7.1 (K), D_LED8.1 (K), R47.1, R50.1, U_LED7.5 (VIN), U_LED8.5 (VIN); also elsewhere on the board
FAN7_GATE: Q_FAN7.1 (G), R53.2, R54.1
FAN7_PWM: J_R4.9, Q_FAN7.3 (D)
FAN7_TACH: J_R4.5, R55.1, R56.1
FAN7_TACH_MCU: C41.1, R56.2; also elsewhere on the board
FAN8_GATE: Q_FAN8.1 (G), R57.2, R58.1
FAN8_PWM: J_R4.10, Q_FAN8.3 (D)
FAN8_TACH: J_R4.6, R59.1, R60.1
FAN8_TACH_MCU: C42.1, R60.2; also elsewhere on the board
FAN_V: J_R4.7; also elsewhere on the board
GND: C35.2, C36.2, C37.2, C38.2, C39.2, C40.2, C41.2, C42.2, J_R4.8, Q_FAN7.2 (S), Q_FAN8.2 (S), R49.2, R52.2, R54.2, R58.2, U_LED7.2 (GND), U_LED8.2 (GND); also elsewhere on the board
LED7_CTRL: C35.1, R48.2, R49.1, U_LED7.3 (CTRL)
LED7_LED_N: J_R4.2, L8.1
LED7_LED_P: J_R4.1, R47.2, U_LED7.4 (SET)
LED7_SW: D_LED7.2 (A), L8.2, U_LED7.1 (SW)
LED8_CTRL: C38.1, R51.2, R52.1, U_LED8.3 (CTRL)
LED8_LED_N: J_R4.4, L9.1
LED8_LED_P: J_R4.3, R50.2, U_LED8.4 (SET)
LED8_SW: D_LED8.2 (A), L9.2, U_LED8.1 (SW)
unnamed 85: R48.1; also elsewhere on the board
unnamed 86: R51.1; also elsewhere on the board
unnamed 87: R53.1; also elsewhere on the board
unnamed 88: R57.1; also elsewhere on the board

Notes on the sheet:
REACTOR 4
LED 7 | 233 mA nominal | external LED via ribbon
LED+ and LED- are NOT ground. Keep the sense connections short.
LED 8 | 233 mA nominal | external LED via ribbon
STIR fan 7 | PWM + RPM feedback
25 kHz, inverted duty. Gate pulldown defaults fan to full speed.
COOL fan 8 | PWM + RPM feedback
10-way ribbon -> first C.5 board IN 1 LED A+ 2 LED A- 3 LED B+ 4 LED B- 5 stir tach 6 cool tach 7 fan V 8 GND 9 stir PWM 10 cool PWM

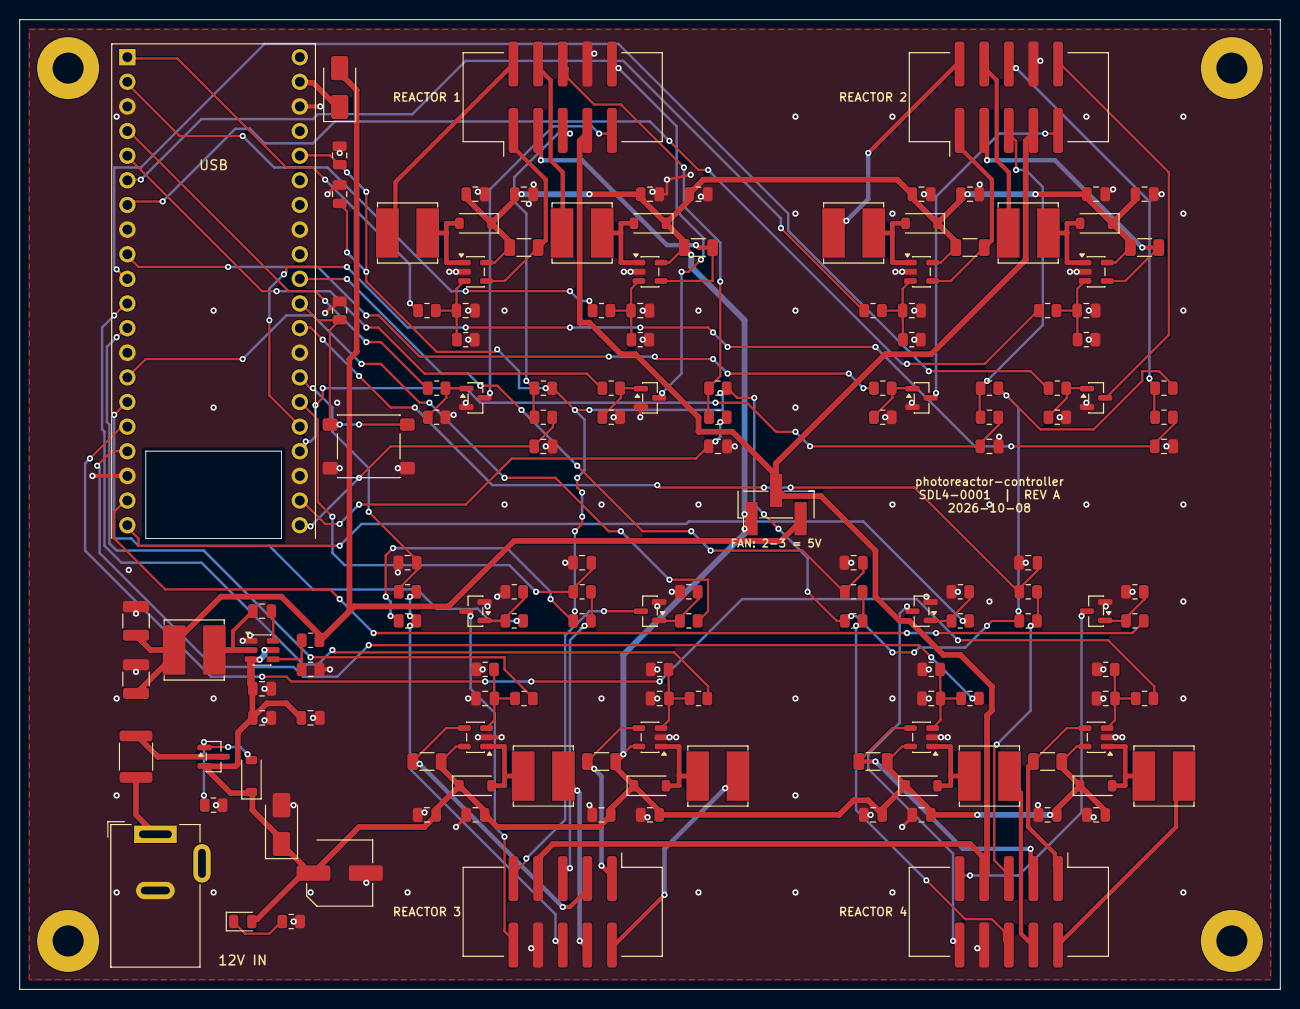
[picture p40: board photoreactor_quad.kicad_pcb from above]

Board: 2 copper layers, 130.0 x 100.0 mm, 154 parts (0 on the bottom side), 94 nets.
